koson/psu-hw/Consolidated/KiCad/AC_soft-start,_+5V_power.kicad_sch

## KiCad design Consolidated/KiCad/AC_soft-start,_+5V_power.kicad_sch (2021-06-04)

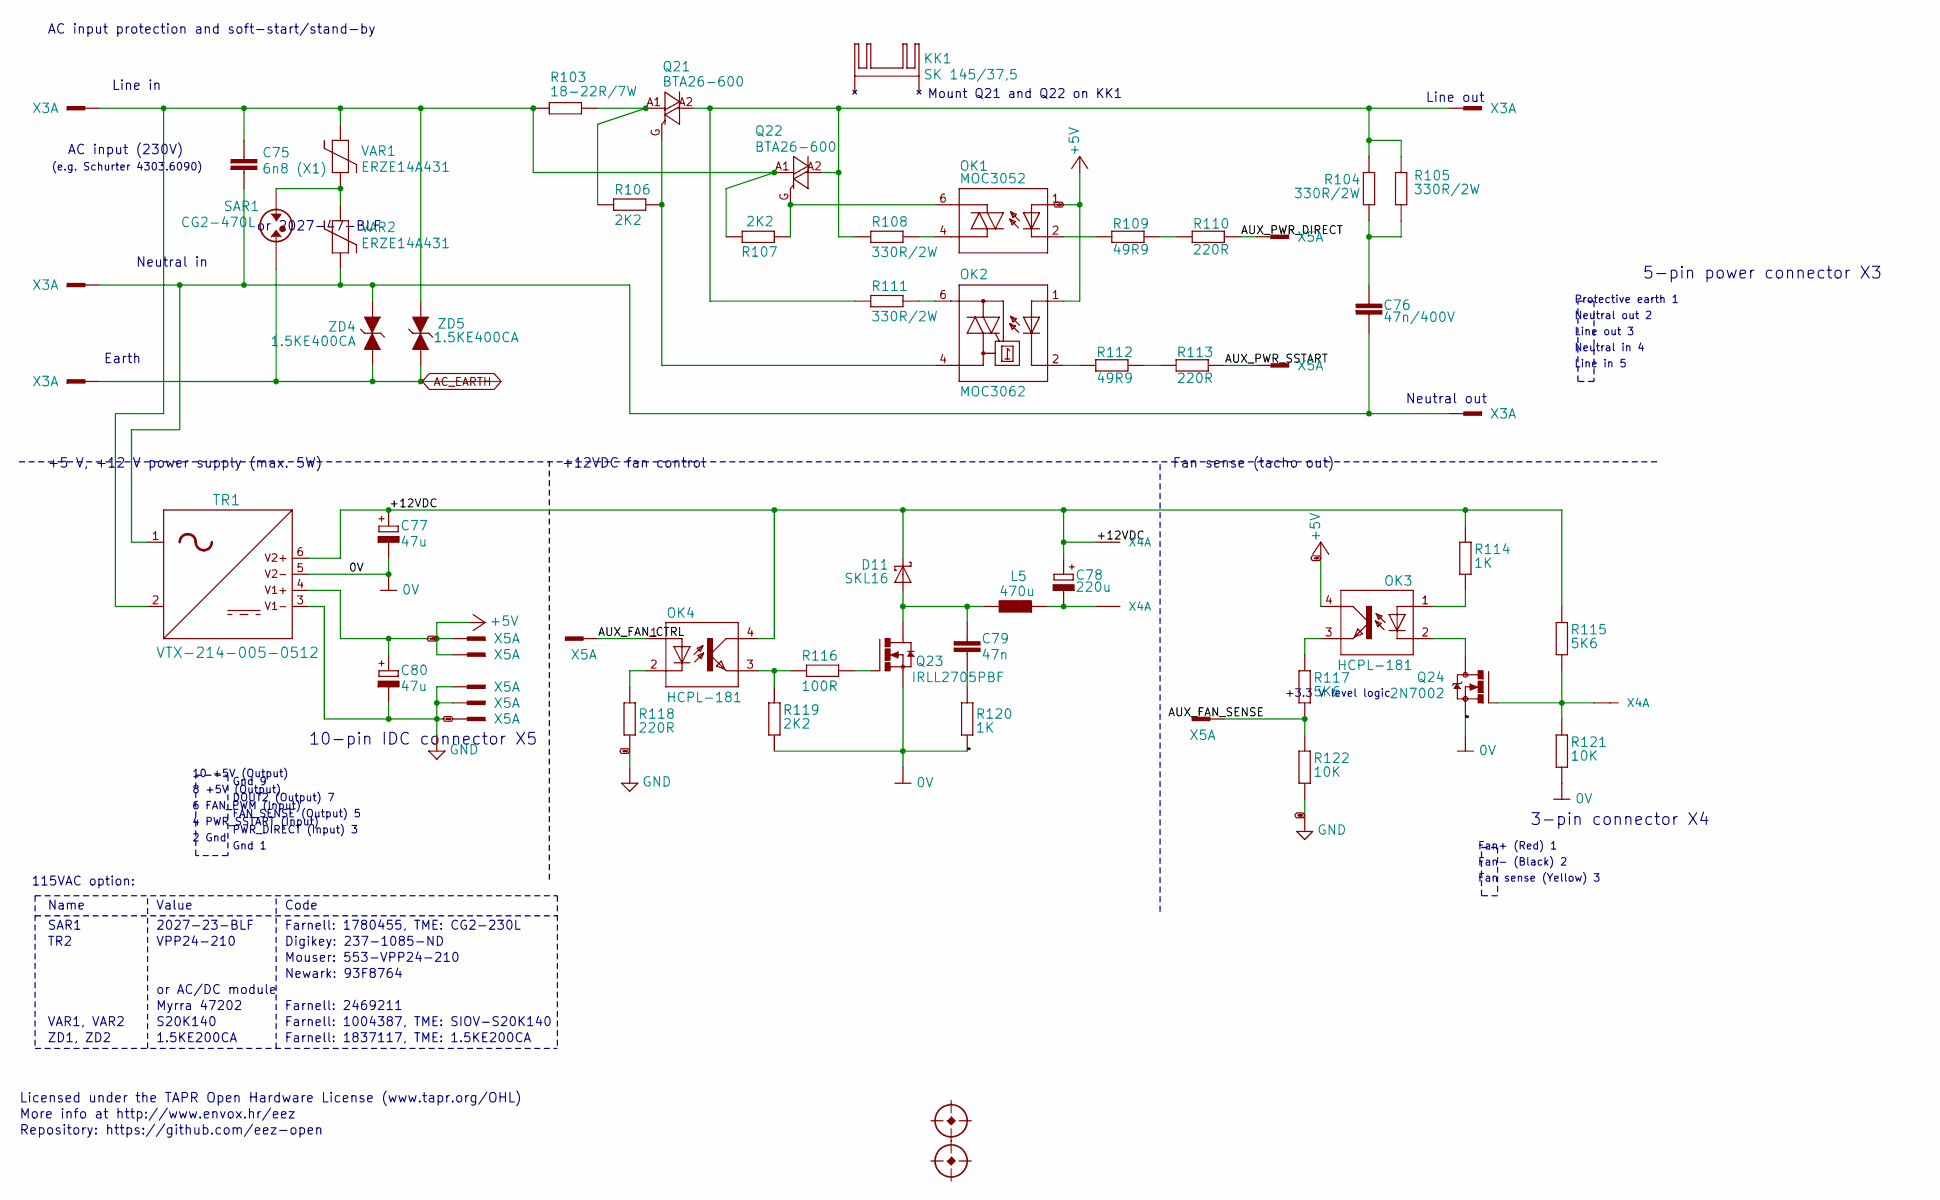
[picture p1: schematic AC_soft-start,_+5V_power.kicad_sch]

Parts:
C75: 6n8 (X1); C102-064X133
C76: 47n/400V; C075-052X106
C77, C80: 47u; CAPAE660X610N
C78: 220u; CAPAE660X610N
C79: 47n; C0805
D11: SKL16; SOD123
FM3, FM4: FIDUCIAL_2; FIDUCIAL_DUAL
KK1: SK 145/37,5; SK145
L5: 470u; DE0704
OK1: MOC3052; DIL6-SMD
OK2: MOC3062; DIL6-SMD
OK3, OK4: HCPL-181
Q21, Q22: BTA26-600; TOP3S-1
Q23: IRLL2705PBF; SOT223
Q24: 2N7002; SOT103P240X110-3N
R103: 18-22R/7W; R_0913
R104, R105, R108, R111: 330R/2W; R2512
R106, R107, R119: 2K2; R0805
R109, R112: 49R9; R0805
R110, R113, R118: 220R; R0805
R114, R120: 1K; R0805
R115, R117: 5K6; R0805
R116: 100R; R0805
R121, R122: 10K; R0805
SAR1: CG2-470L; SAR
TR1: VTX-214-005-0512; PCB_ACDC_VTX_5W_DUAL
VAR1, VAR2: ERZE14A431; VARISTOR
X3: 39303055; MINIFIT_6659-5
X4: 22-23-2031
X5: 09185067324; IDC-10PIN
ZD4, ZD5: 1.5KE400CA; DO201-BIDIR

Connections:
0V: C77.2 (-), Q23.3 (S), Q24.2 (S), R119.1, R120.1, R121.2, TR1.5 (V2-)
+5V: C80.1 (+), OK1.1 (A), OK2.1 (A), OK3.4 (COL), TR1.4 (V1+), X5.1
+12VDC: C77.1 (+), C78.1 (+), D11.C, OK4.4 (COL), R114.1, R115.1, TR1.6 (V2+), X4.1
AC_EARTH: SAR1.P$2, X3.4, ZD4.C (1), ZD5.C (1)
AUX_FAN_CTRL: OK4.1 (A), X5.1
AUX_FAN_SENSE: R117.2, R122.1, X5.1
AUX_PWR_DIRECT: R110.2, X5.1
AUX_PWR_SSTART: R113.2, X5.1
GND: C80.2 (-), R118.2, R122.2, TR1.3 (V1-), X5.1
unnamed: C75.1, Q22.A1, R103.1, R107.2, TR1.2 (IN2), VAR1.P$2, X3.4, ZD5.A (2)
unnamed: C75.2, C76.1, TR1.1 (IN1), VAR2.P$1, X3.4, ZD4.A (2)
unnamed: C76.2, R104.2, R105.2
unnamed: C78.2 (-), L5.1, X4.1
unnamed: C79.1, R120.2
unnamed: C79.2, D11.A, L5.2, Q23.2 (D), Q23.4 (D)
unnamed: OK1.2 (C), R109.1
unnamed: OK1.4 (A1), R108.1
unnamed: OK1.6 (A2), Q22.G, R107.1
unnamed: OK2.2 (C), R112.1
unnamed: OK2.4 (A1), Q21.G, R106.2
unnamed: OK2.6 (A2), R111.1
unnamed: OK3.1 (A), R114.2
unnamed: OK3.2 (C), Q24.3 (D)
unnamed: OK3.3 (EMIT), R117.1
unnamed: OK4.2 (C), R118.1
unnamed: OK4.3 (EMIT), R116.2, R119.2
unnamed: Q21.A1, R103.2, R106.1
unnamed: Q21.A2, Q22.A2, R104.1, R105.1, R108.2, R111.2, X3.4
unnamed: Q23.1 (G), R116.1
unnamed: Q24.1 (G), R115.2, R121.1, X4.1
unnamed: R109.2, R110.1
unnamed: R112.2, R113.1
unnamed: SAR1.P$1, VAR1.P$1, VAR2.P$2

Notes on the sheet:
Licensed under the TAPR Open Hardware License (www.tapr.org/OHL)
More info at http://www.envox.hr/eez
Repository: https://github.com/eez-open
115VAC option:
AC input protection and soft-start/stand-by
+5 V, +12 V power supply (max. 5W)
Name
SAR1
TR2
VAR1, VAR2
ZD1, ZD2
(e.g. Schurter 4303.6090)
AC input (230V)
Earth
Line in
Neutral in
Value
2027-23-BLF
VPP24-210
or AC/DC module
Myrra 47202
S20K140
1.5KE200CA
10 +5V (Output)
8 +5V (Output)
6 FAN_PWM (Input)
4 PWR_SSTART (Input)
2 Gnd
Gnd 9
DOUT2 (Output) 7
FAN_SENSE (Output) 5
PWR_DIRECT (Input) 3
Gnd 1
or 2027-47-BLF
Code
Farnell: 1780455, TME: CG2-230L
Digikey: 237-1085-ND
Mouser: 553-VPP24-210
Newark: 93F8764
Farnell: 2469211
Farnell: 1004387, TME: SIOV-S20K140
Farnell: 1837117, TME: 1.5KE200CA
10-pin IDC connector X5
+12VDC fan control
Mount Q21 and Q22 on KK1
Fan sense (tacho out)
+3.3 V level logic
Neutral out
Line out
Fan+ (Red) 1
Fan- (Black) 2
Fan sense (Yellow) 3
3-pin connector X4
Protective earth 1
Neutral out 2
Line out 3
Neutral in 4
Line in 5
5-pin power connector X3
