koson/psu-hw/Consolidated/KiCad/Bias_power.kicad_sch

## KiCad design Consolidated/KiCad/Bias_power.kicad_sch (2021-06-04)

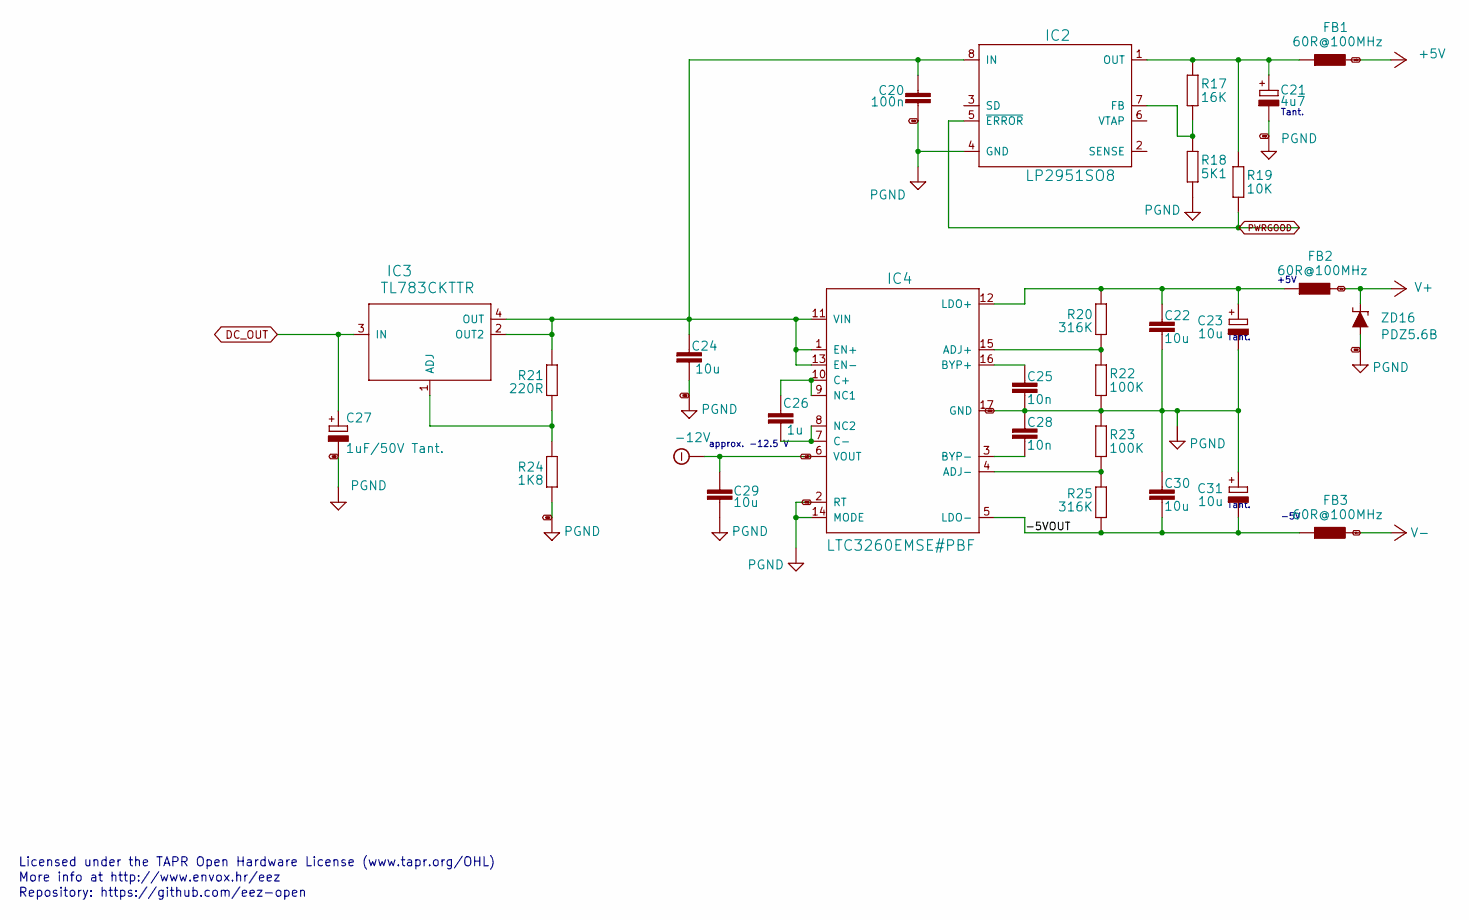
[picture p2: schematic Bias_power.kicad_sch]

Parts:
C20: 100n; C0603
C21: 4u7; EC1206
C22, C24, C29, C30: 10u; C1210
C23, C31: 10u; EC1206
C25, C28: 10n; C0805
C26: 1u; C0805
C27: 1uF/50V Tant.; C_6032-28R
FB1, FB2, FB3: 60R@100MHz; BEAD0603
IC2: LP2951SO8; SOIC127P600X175-8N
IC3: TL783CKTTR; TO254P1524X483-4N
IC4: LTC3260EMSE#PBF; SOP50P490X110-17N
R17: 16K; R0805
R18: 5K1; R0805
R19: 10K; R0805
R20, R25: 316K; R0805
R21: 220R; R0805
R22, R23: 100K; R0805
R24: 1K8; R0805
ZD16: PDZ5.6B; SOD323-W

Connections:
+5V: FB1.P$2 (2)
-5VOUT: C30.2, C31.-, FB3.P$1 (1), IC4.5 (LDO-), R25.2
-12V: C29.1, IC4.6 (VOUT)
DC_OUT: C27.+, IC3.3 (IN)
GND: C20.2, C21.-, C22.2, C23.-, C24.2, C25.1, C27.-, C28.1, C29.2, C30.1, C31.+, IC2.4 (GND), IC4.2 (RT), IC4.14 (MODE), IC4.17 (GND), R18.2, R22.2, R23.1, R24.2, ZD16.A
unnamed: C20.1, C24.1, IC2.8 (IN), IC3.2 (OUT2), IC3.4 (OUT), IC4.1 (EN+), IC4.11 (VIN), IC4.13 (EN-), R21.1
unnamed: C21.+, FB1.P$1 (1), IC2.1 (OUT), R17.1, R19.1
unnamed: C22.1, C23.+, FB2.P$1 (1), IC4.12 (LDO+), R20.1
unnamed: C25.2, IC4.16 (BYP+)
unnamed: C26.1, IC4.9 (NC1), IC4.10 (C+)
unnamed: C26.2, IC4.7 (C-), IC4.8 (NC2)
unnamed: C28.2, IC4.3 (BYP-)
unnamed: IC2.7 (FB), R17.2, R18.1
unnamed: IC3.1 (ADJ), R21.2, R24.1
unnamed: IC4.4 (ADJ-), R23.2, R25.1
unnamed: IC4.15 (ADJ+), R20.2, R22.1
PWRGOOD: IC2.5 (~ERROR), R19.2
V+: FB2.P$2 (2), ZD16.C
V-: FB3.P$2 (2)

Notes on the sheet:
Licensed under the TAPR Open Hardware License (www.tapr.org/OHL)
More info at http://www.envox.hr/eez
Repository: https://github.com/eez-open
approx. -12.5 V
Tant.
+5V
-5V
