koson/psu-hw/Consolidated/KiCad/Binding_posts_relays,_LED_driver.kicad_sch

## KiCad design Consolidated/KiCad/Binding_posts_relays,_LED_driver.kicad_sch (2021-06-04)

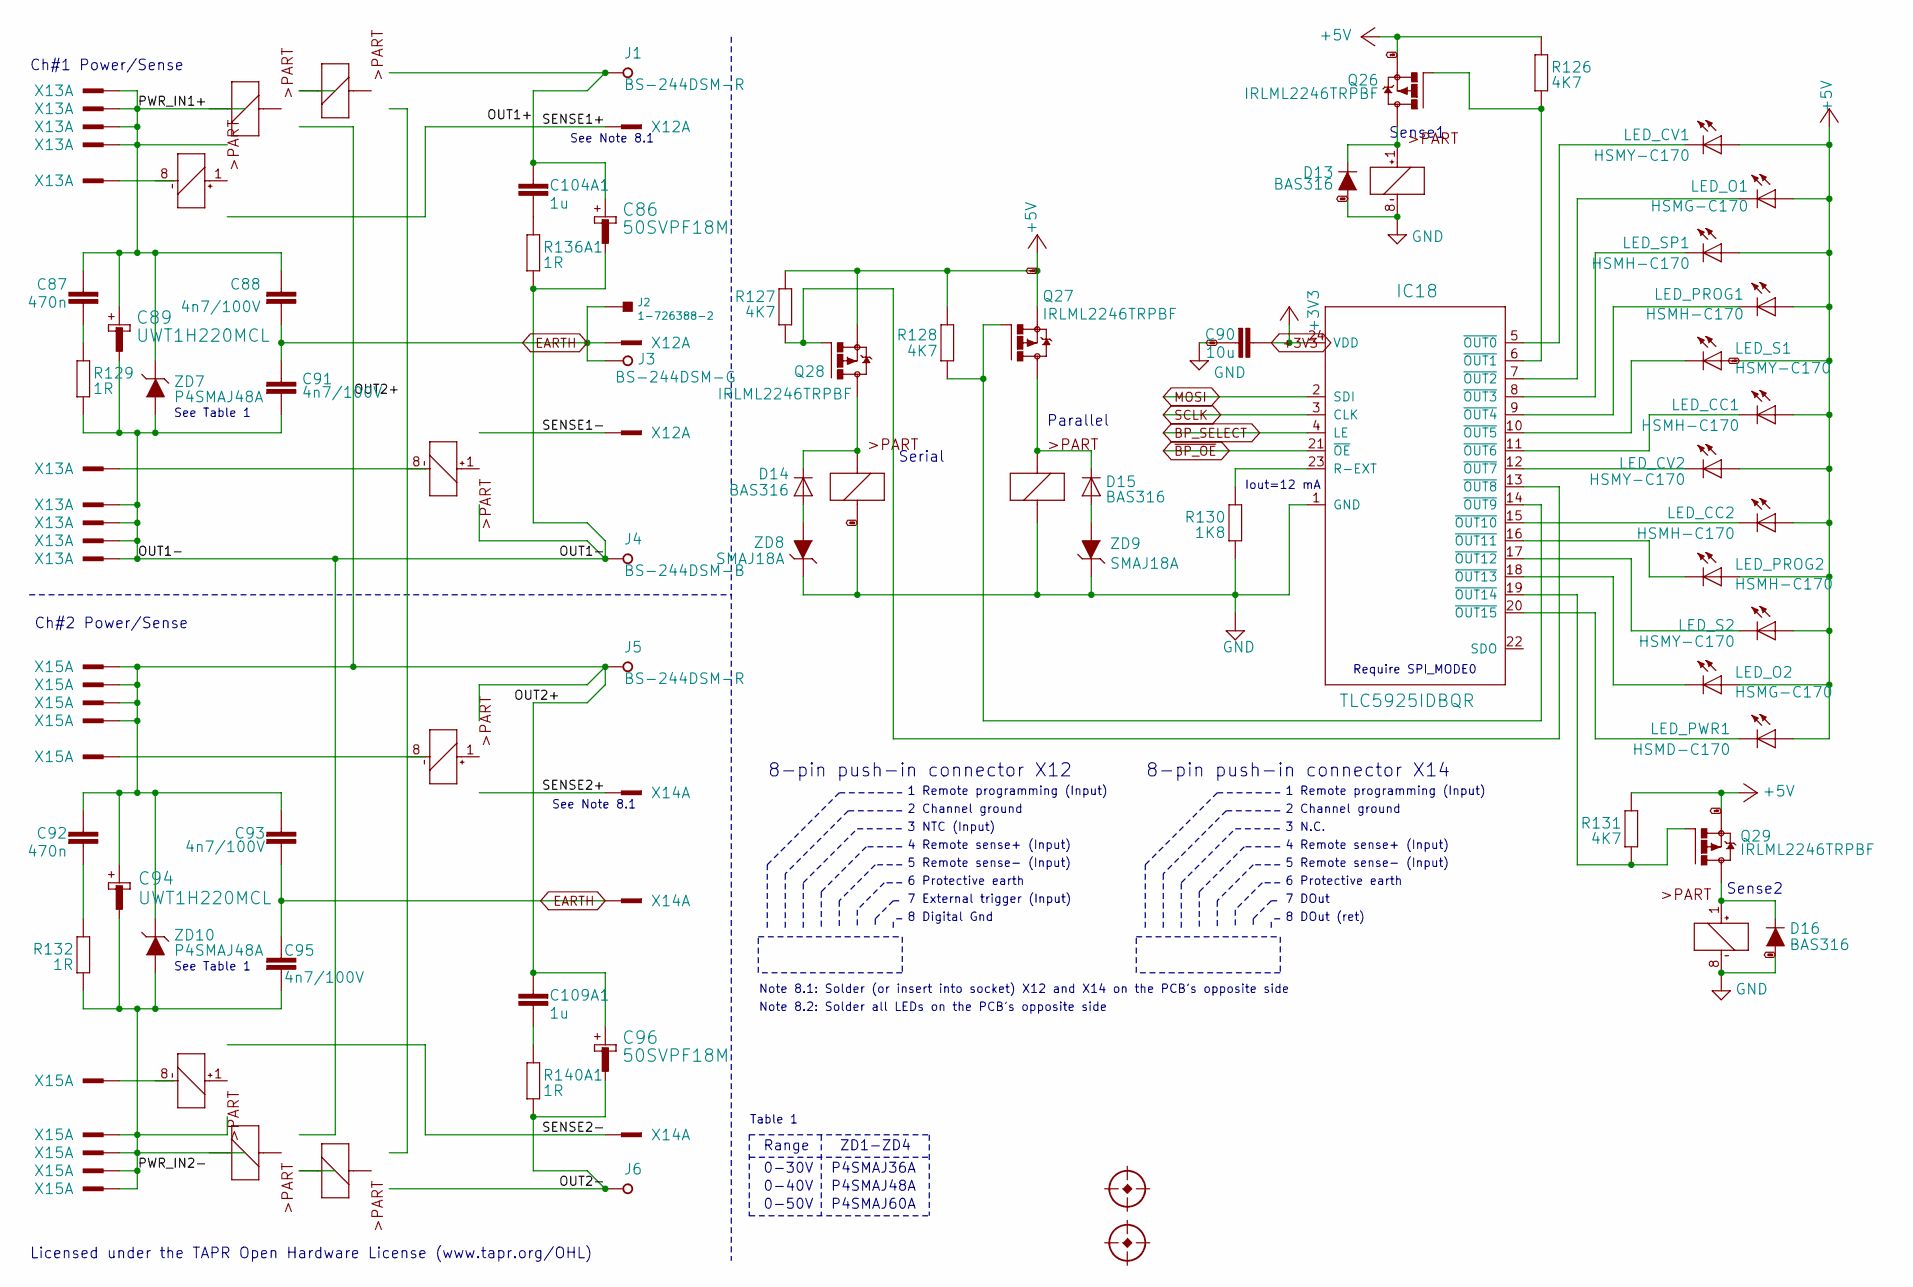
[picture p3: schematic Binding_posts_relays,_LED_driver.kicad_sch]

Parts:
C86, C96: 50SVPF18M; CAPAE830X650N
C87, C92: 470n; C0805
C88, C91, C93, C95: 4n7/100V; C1210
C89, C94: UWT1H220MCL; CAPAE830X650N
C90: 10u; C1210
C104A1, C109A1: 1u; C0805
D13, D16: BAS316; SOD323-R
D14, D15: BAS316; SOD323-W
FM5, FM6: FIDUCIAL_2; FIDUCIAL_DUAL
IC18: TLC5925IDBQR; SOP63P600X175-24N
J1, J5: BS-244DSM-R; BP_5_12
J2: 1-726388-2; PCB_TAB-4.8MM
J3: BS-244DSM-G; BP_5_12
J4, J6: BS-244DSM-B; BP_5_12
K_PAR1: RT424005; RT-C_016A5_ROUND
K_S1, K_S2: G6K-2F-5DC; G6K-2F
K_SER1: RT424005; RT-C_016A5_ROUND
LED_CC1, LED_CC2: HSMH-C170; LED_HSMH-C170
LED_CV1, LED_CV2: HSMY-C170; LED_0805
LED_O1, LED_O2: HSMG-C170; LED_0805
LED_PROG1, LED_PROG2: HSMH-C170; LED_HSMH-C170
LED_PWR1: HSMD-C170; LED_0805
LED_S1, LED_S2: HSMY-C170; LED_0805
LED_SP1: HSMH-C170; LED_HSMH-C170
Q26, Q27, Q28, Q29: IRLML2246TRPBF; SOT95P237X112-3N
R126, R127, R128, R131: 4K7; R0805
R129, R132, R136A1, R140A1: 1R; R0805
R130: 1K8; R0805
X12, X14: MC000006; MC000006_MIRROR
X13, X15: TSW-113-07-F-D
ZD7, ZD10: P4SMAJ48A; DO214AC
ZD8, ZD9: SMAJ18A; DO214AC

Connections:
+3V3: C90.1, IC18.24 (VDD)
+5V: LED_CC1.A, LED_CC2.A, LED_CV1.A, LED_CV2.A, LED_O1.A, LED_O2.A, LED_PROG1.A, LED_PROG2.A, LED_PWR1.A, LED_S1.A, LED_S2.A, LED_SP1.A, Q26.2 (S), Q27.2 (S), Q28.2 (S), Q29.2 (S), R126.2, R127.2, R128.2, R131.2
BP_SELECT: IC18.4 (LE)
EARTH: C88.2, C91.1, C93.2, C95.1, J2.P$1, J2.P$2, J3.P$1, X12.1, X12.1.1, X14.1, X14.1.1
GND: C90.2, D13.A, D16.A, IC18.1 (GND), K_PAR1.A1 (C2), K_S1.8 (-), K_S2.8 (-), K_SER1.A1 (C2), R130.1, ZD8.C, ZD9.C
MOSI: IC18.2 (SDI)
unnamed: C87.2, R129.2
unnamed: C92.2, R132.2
unnamed: C104A1.2, R136A1.2
unnamed: C109A1.2, R140A1.2
unnamed: D13.C, K_S1.1 (+), Q26.3 (D)
unnamed: D14.A, ZD8.A
unnamed: D14.C, K_SER1.A2 (C1), Q28.3 (D)
unnamed: D15.A, ZD9.A
unnamed: D15.C, K_PAR1.A2 (C1), Q27.3 (D)
unnamed: D16.C, K_S2.1 (+), Q29.3 (D)
unnamed: IC18.5 (~OUT0), LED_CV1.C
unnamed: IC18.6 (~OUT1), Q26.1 (G), R126.1
unnamed: IC18.7 (~OUT2), LED_O1.C
unnamed: IC18.8 (~OUT3), LED_SP1.C
unnamed: IC18.9 (~OUT4), LED_PROG1.C
unnamed: IC18.10 (~OUT5), LED_S1.C
unnamed: IC18.11 (~OUT6), LED_CC1.C
unnamed: IC18.12 (~OUT7), LED_CV2.C
unnamed: IC18.13 (~OUT8), Q28.1 (G), R127.1
unnamed: IC18.14 (~OUT9), Q27.1 (G), R128.1
unnamed: IC18.15 (~OUT10), LED_CC2.C
unnamed: IC18.16 (~OUT11), LED_PROG2.C
unnamed: IC18.17 (~OUT12), LED_S2.C
unnamed: IC18.18 (~OUT13), LED_O2.C
unnamed: IC18.19 (~OUT14), Q29.1 (G), R131.1
unnamed: IC18.20 (~OUT15), LED_PWR1.C
unnamed: IC18.23 (R-EXT), R130.2
OUT1+: C86.1, C104A1.1, J1.P$1
OUT1-: C86.2, C89.2, C91.2, J4.P$1, R129.1, R136A1.1, X13.1, ZD7.A
OUT2+: C92.1, C93.1, C94.1, C96.1, C109A1.1, J5.P$1, X15.1, ZD10.C
OUT2-: C96.2, J6.P$1, R140A1.1
PWR_IN1+: C87.1, C88.1, C89.1, X13.1, ZD7.C
PWR_IN2-: C94.2, C95.2, R132.1, X15.1, ZD10.A
SCLK: IC18.3 (CLK)
SENSE1+: X12.1, X12.1.1
SENSE1-: X12.1, X12.1.1
SENSE2+: X14.1, X14.1.1
SENSE2-: X14.1, X14.1.1
~BP_OE: IC18.21 (~OE)

Notes on the sheet:
Ch#1 Power/Sense
Licensed under the TAPR Open Hardware License (www.tapr.org/OHL)
Ch#2 Power/Sense
See Table 1
See Note 8.1
Table 1
Note 8.1: Solder (or insert into socket~) X12 and X14 on the PCB's opposite side
Note 8.2: Solder all LEDs on the PCB's opposite side
Range
0-30V
0-40V
0-50V
8-pin push-in connector X12
P4SMAJ36A
P4SMAJ48A
P4SMAJ60A
ZD1-ZD4
Serial
1 Remote programming (Input)
2 Channel ground
3 NTC (Input)
4 Remote sense+ (Input)
5 Remote sense- (Input)
6 Protective earth
7 External trigger (Input)
8 Digital Gnd
Parallel
8-pin push-in connector X14
Iout=12 mA
3 N.C.
7 DOut
8 DOut (ret)
Require SPI_MODE0
Sense1
Sense2
