koson/psu-hw/Consolidated/KiCad/CC%2fCV,_Remote_sense_protection.kicad_sch

## KiCad design Consolidated/KiCad/CC%2fCV,_Remote_sense_protection.kicad_sch (2021-06-04)

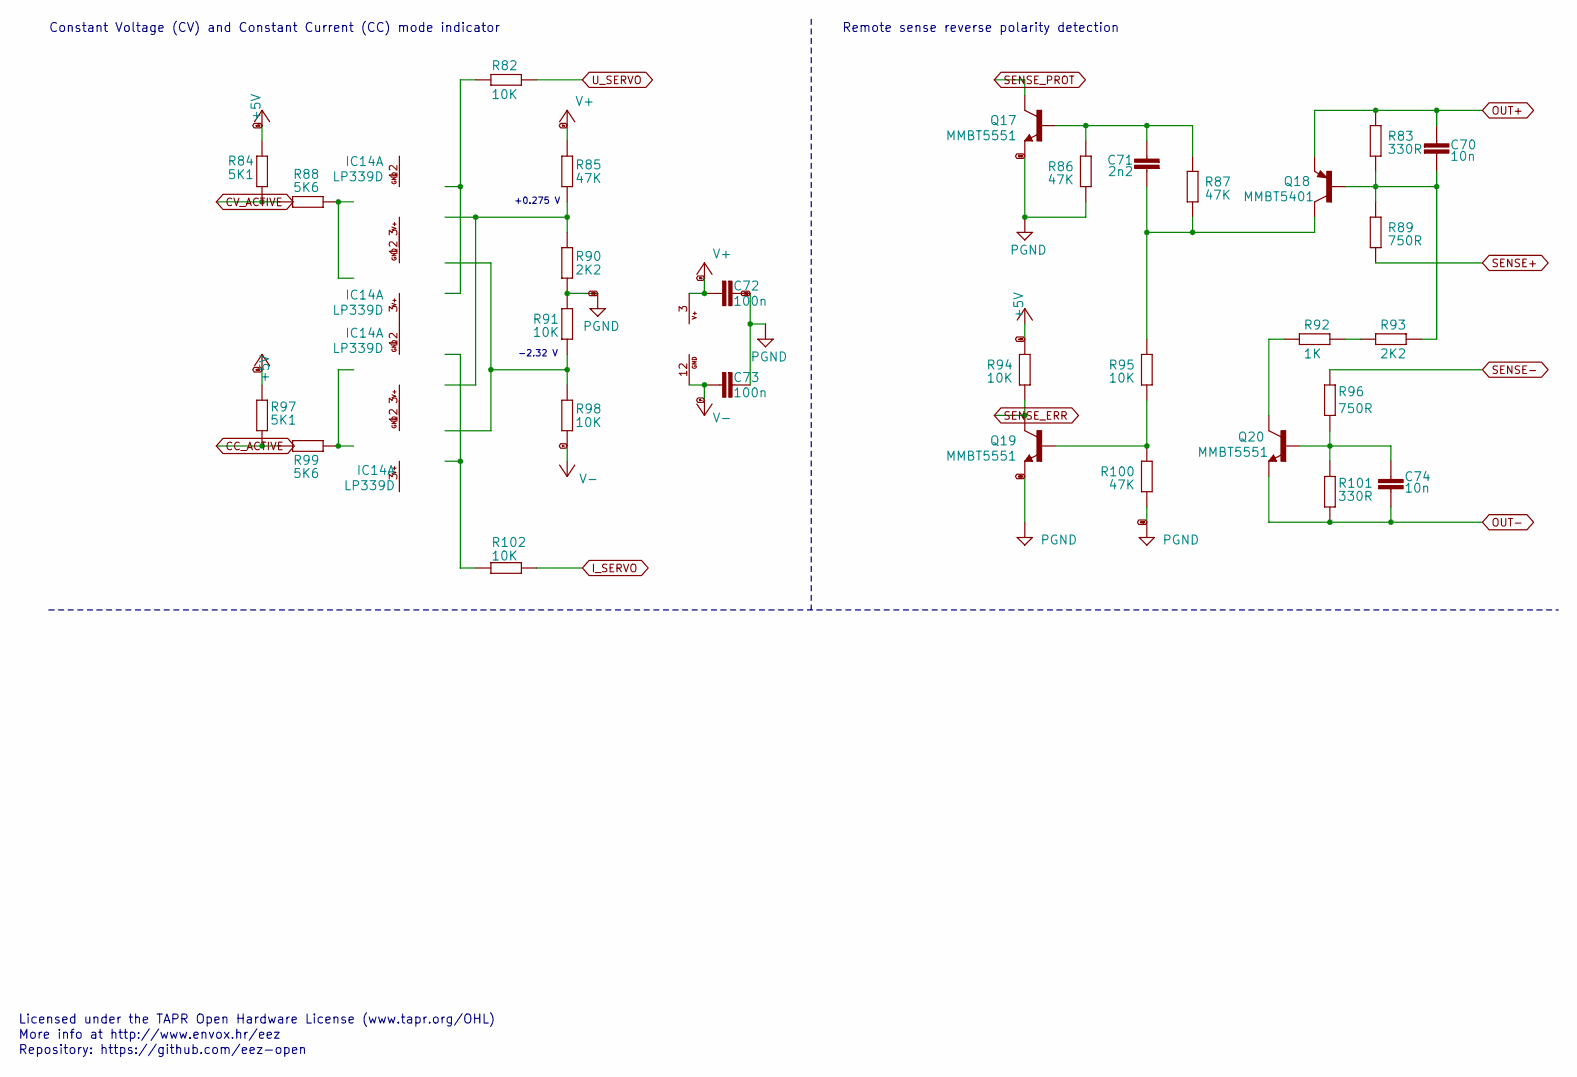
[picture p4: schematic CC%2fCV,_Remote_sense_protection.kicad_sch]

Parts:
C70, C74: 10n; C0805
C71: 2n2; C0805
C72, C73: 100n; C0603
IC14: LP339D; SOIC127P600X175-14N
Q17, Q19, Q20: MMBT5551; SOT23-BEC
Q18: MMBT5401; SOT23-BEC
R82, R91, R94, R95, R98, R102: 10K; R0805
R83, R101: 330R; R0805
R84, R97: 5K1; R0805
R85, R86, R87, R100: 47K; R0805
R88, R99: 5K6; R0805
R89, R96: 750R; R0805
R90, R93: 2K2; R0805
R92: 1K; R0805

Connections:
+5V: R84.2, R94.2, R97.2
CC_ACTIVE: R97.1, R99.2
CV_ACTIVE: R84.1, R88.2
GND: C72.1, C73.1, Q17.E, Q19.E, R86.1, R90.1, R91.2, R100.1
I_SERVO: R102.1
unnamed: C70.2, Q18.B, R83.1, R89.2, R93.2
unnamed: C71.1, Q17.B, R86.2, R87.2
unnamed: C71.2, Q18.C, R87.1, R95.2
unnamed: C74.1, Q20.B, R96.1, R101.2
unnamed: IC14.3 (V+), IC14.12 (GND)
unnamed: Q19.B, R95.1, R100.2
unnamed: Q20.C, R92.1
unnamed: R85.1, R90.2
unnamed: R91.1, R98.2
unnamed: R92.2, R93.1
OUT+: C70.1, Q18.E, R83.2
OUT-: C74.2, Q20.E, R101.1
SENSE+: R89.1
SENSE-: R96.2
SENSE_ERR: Q19.C, R94.1
SENSE_PROT: Q17.C
U_SERVO: R82.1
V+: C72.2, IC14.3 (V+), R85.2
V-: C73.2, IC14.12 (GND), R98.1

Notes on the sheet:
Licensed under the TAPR Open Hardware License (www.tapr.org/OHL)
More info at http://www.envox.hr/eez
Repository: https://github.com/eez-open
Constant Voltage (CV) and Constant Current (CC) mode indicator
+0.275 V
-2.32 V
Remote sense reverse polarity detection
