koson/psu-hw/Consolidated/KiCad/Digital_control,_voltage_reference.kicad_sch

## KiCad design Consolidated/KiCad/Digital_control,_voltage_reference.kicad_sch (2021-06-04)

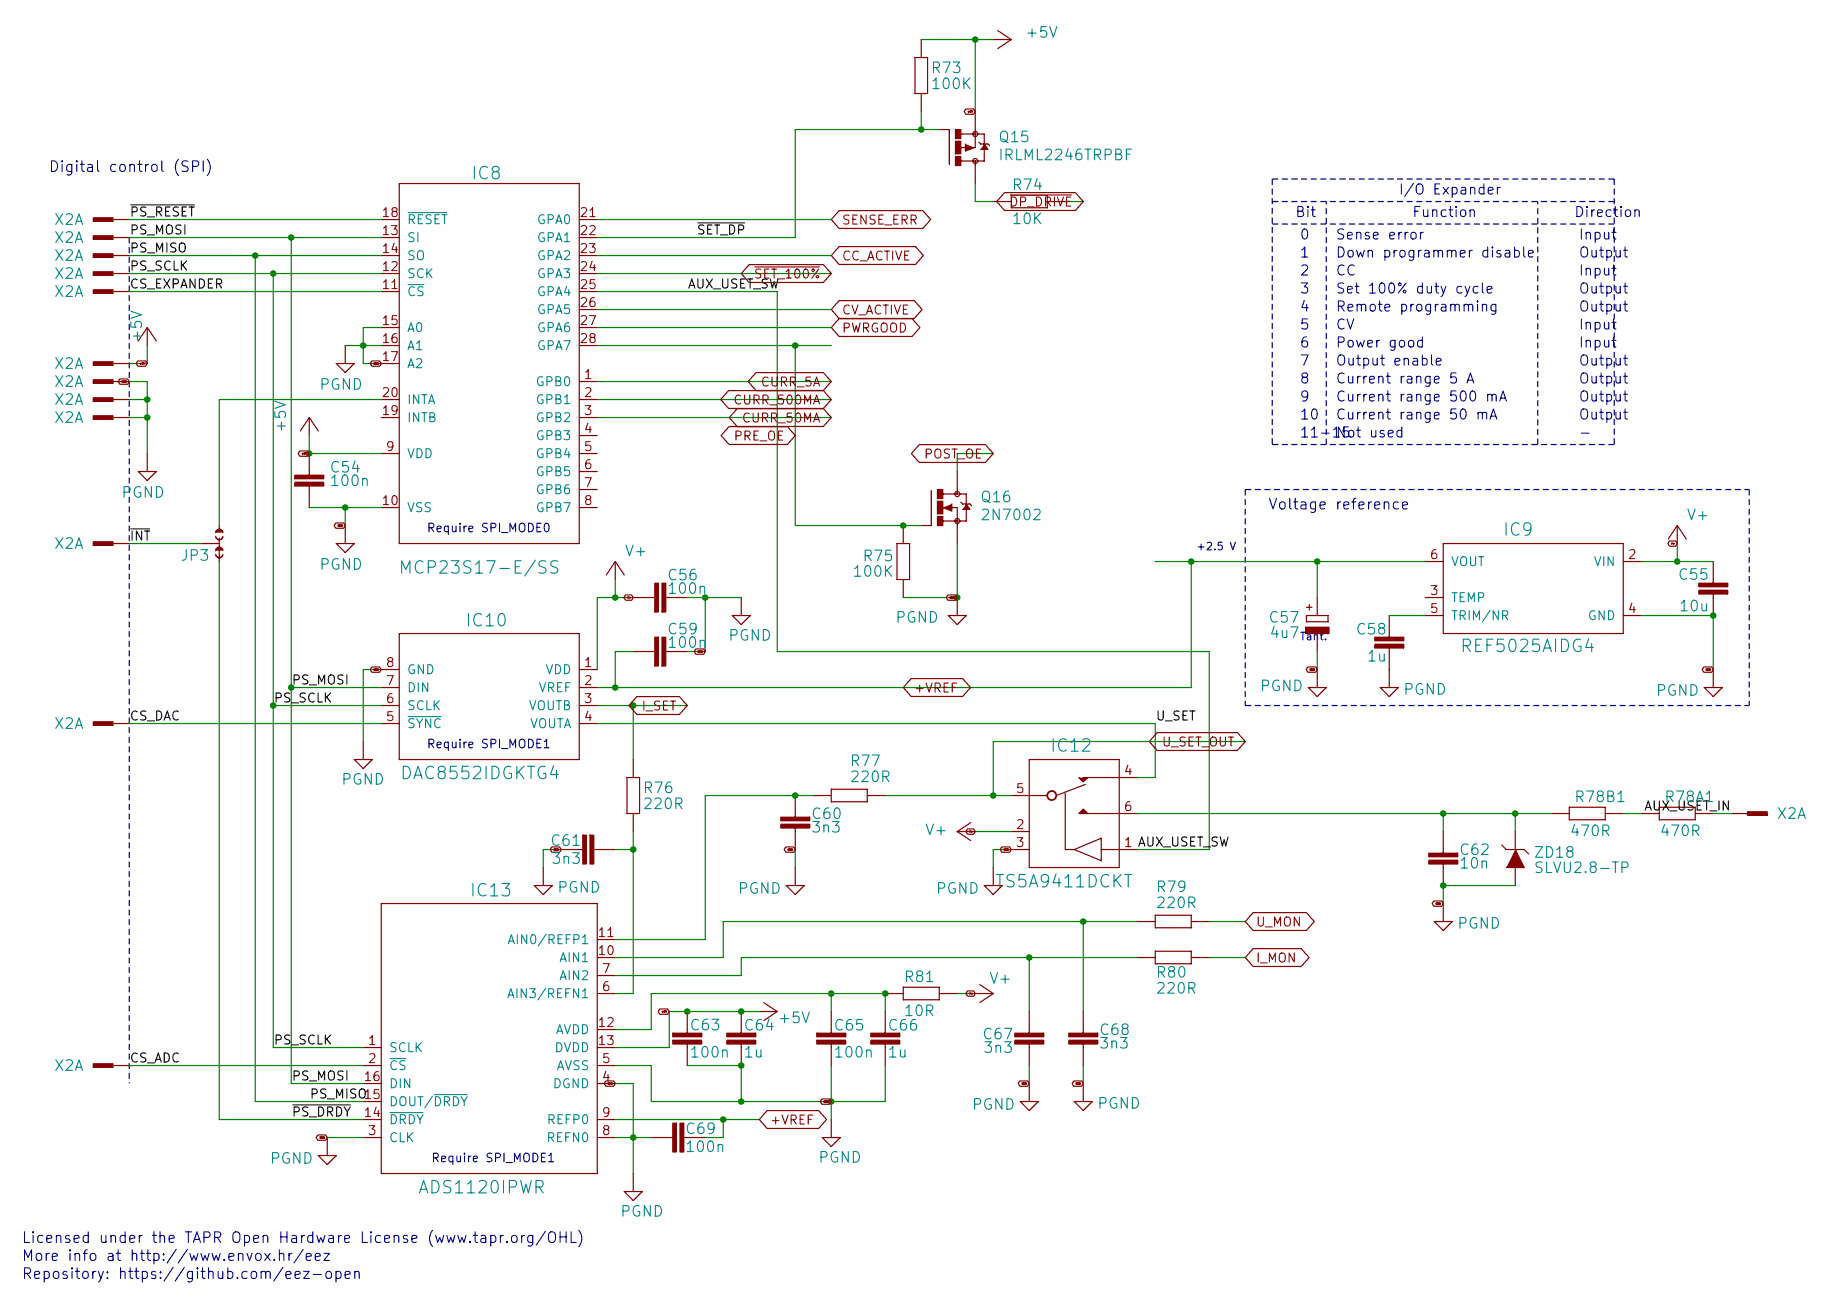
[picture p5: schematic Digital_control,_voltage_reference.kicad_sch]

Parts:
C54, C56, C59, C63, C65, C69: 100n; C0603
C55: 10u; C1210
C57: 4u7; EC1206
C58, C64, C66: 1u; C0805
C60, C61, C67, C68: 3n3; C0805
C62: 10n; C0805
IC8: MCP23S17-E/SS; SOP65P780X200-28N
IC9: REF5025AIDG4; SOIC127P600X175-8N
IC10: DAC8552IDGKTG4; DGK8-M
IC12: TS5A9411DCKT; SOT65P210X110-6N
IC13: ADS1120IPWR; PW(R-PDSO-G16)
JP3: JP3-CUT
Q15: IRLML2246TRPBF; SOT95P237X112-3N
Q16: 2N7002; SOT103P240X110-3N
R73, R75: 100K; R0805
R74: 10K; R0805
R76, R77, R79, R80: 220R; R0805
R78A1, R78B1: 470R; R0805
R81: 10R; R1206
X2: SSW-113-02-T-D-RA
ZD18: SLVU2.8-TP; SOT23

Connections:
+5V: C54.1, C63.2, C64.2, IC8.9 (VDD), IC13.13 (DVDD), Q15.2 (S), R73.1, X2.1
+VREF: C57.+, C59.2, C69.2, IC9.6 (VOUT), IC10.2 (VREF), IC13.9 (REFP0)
AUX_USET_IN: R78A1.2, X2.1
AUX_USET_SW: IC8.25 (GPA4), IC12.1 (IN)
CC_ACTIVE: IC8.23 (GPA2)
CS_ADC: IC13.2 (~CS), X2.1
CS_DAC: IC10.5 (~SYNC), X2.1
CS_EXPANDER: IC8.11 (~CS), X2.1
CURR_5A: IC8.1 (GPB0)
CURR_50MA: IC8.3 (GPB2)
CURR_500MA: IC8.2 (GPB1)
CV_ACTIVE: IC8.26 (GPA5)
GND: C54.2, C55.2, C56.1, C57.-, C58.2, C59.1, C60.1, C61.2, C62.1, C63.1, C64.1, C65.1, C66.1, C67.1, C68.1, C69.1, IC8.10 (VSS), IC8.15 (A0), IC8.16 (A1), IC8.17 (A2), IC9.4 (GND), IC10.8 (GND), IC12.3 (GND), IC13.3 (CLK), IC13.4 (DGND), IC13.5 (AVSS), IC13.8 (REFN0), Q16.2 (S), R75.1, X2.1, ZD18.1 (A), ZD18.2 (A)
I_MON: R80.1
I_SET: IC10.3 (VOUTB), R76.1
unnamed: C58.1, IC9.5 (TRIM/NR)
unnamed: C60.2, IC13.11 (AIN0/REFP1), R77.2
unnamed: C61.1, IC13.6 (AIN3/REFN1), R76.2
unnamed: C62.2, IC12.6 (S1), R78B1.1, ZD18.3 (C)
unnamed: C65.2, C66.2, IC13.12 (AVDD), R81.2
unnamed: C67.2, IC13.7 (AIN2), R80.2
unnamed: C68.2, IC13.10 (AIN1), R79.2
unnamed: IC8.20 (INTA), JP3.NO
unnamed: Q15.3 (D), R74.2
unnamed: R78A1.1, R78B1.2
POST_OE: Q16.3 (D)
PRE_OE: IC8.28 (GPA7), Q16.1 (G), R75.2
PS_MISO: IC8.14 (SO), IC13.15 (DOUT/~DRDY), X2.1
PS_MOSI: IC8.13 (SI), IC10.7 (DIN), IC13.16 (DIN), X2.1
PS_SCLK: IC8.12 (SCK), IC10.6 (SCLK), IC13.1 (SCLK), X2.1
PWRGOOD: IC8.27 (GPA6)
SENSE_ERR: IC8.21 (GPA0)
U_MON: R79.1
U_SET: IC10.4 (VOUTA), IC12.4 (S2)
U_SET_OUT: IC12.5 (D), R77.1
V+: C55.1, C56.2, IC9.2 (VIN), IC10.1 (VDD), IC12.2 (VDD), R81.1
~DP_DRIVE: R74.1
~INT: JP3.COM, X2.1
~PS_DRDY: IC13.14 (~DRDY), JP3.NC
~PS_RESET: IC8.18 (~RESET), X2.1
~SET_100%: IC8.24 (GPA3)
~SET_DP: IC8.22 (GPA1), Q15.1 (G), R73.2

Notes on the sheet:
Licensed under the TAPR Open Hardware License (www.tapr.org/OHL)
More info at http://www.envox.hr/eez
Repository: https://github.com/eez-open
Digital control (SPI)
Require SPI_MODE0
Require SPI_MODE1
+2.5 V
Voltage reference
Bit
11-15
Tant.
Sense error
Down programmer disable
Set 100% duty cycle
Remote programming
Power good
Output enable
Current range 5 A
Current range 500 mA
Current range 50 mA
Not used
I/O Expander
Function
Direction
Input
Output
