koson/psu-hw/Consolidated/KiCad/EEZ_PSU_consolidated_r5B13a_12.kicad_sch

## KiCad design Consolidated/KiCad/EEZ_PSU_consolidated_r5B13a_12.kicad_sch (2021-06-04)

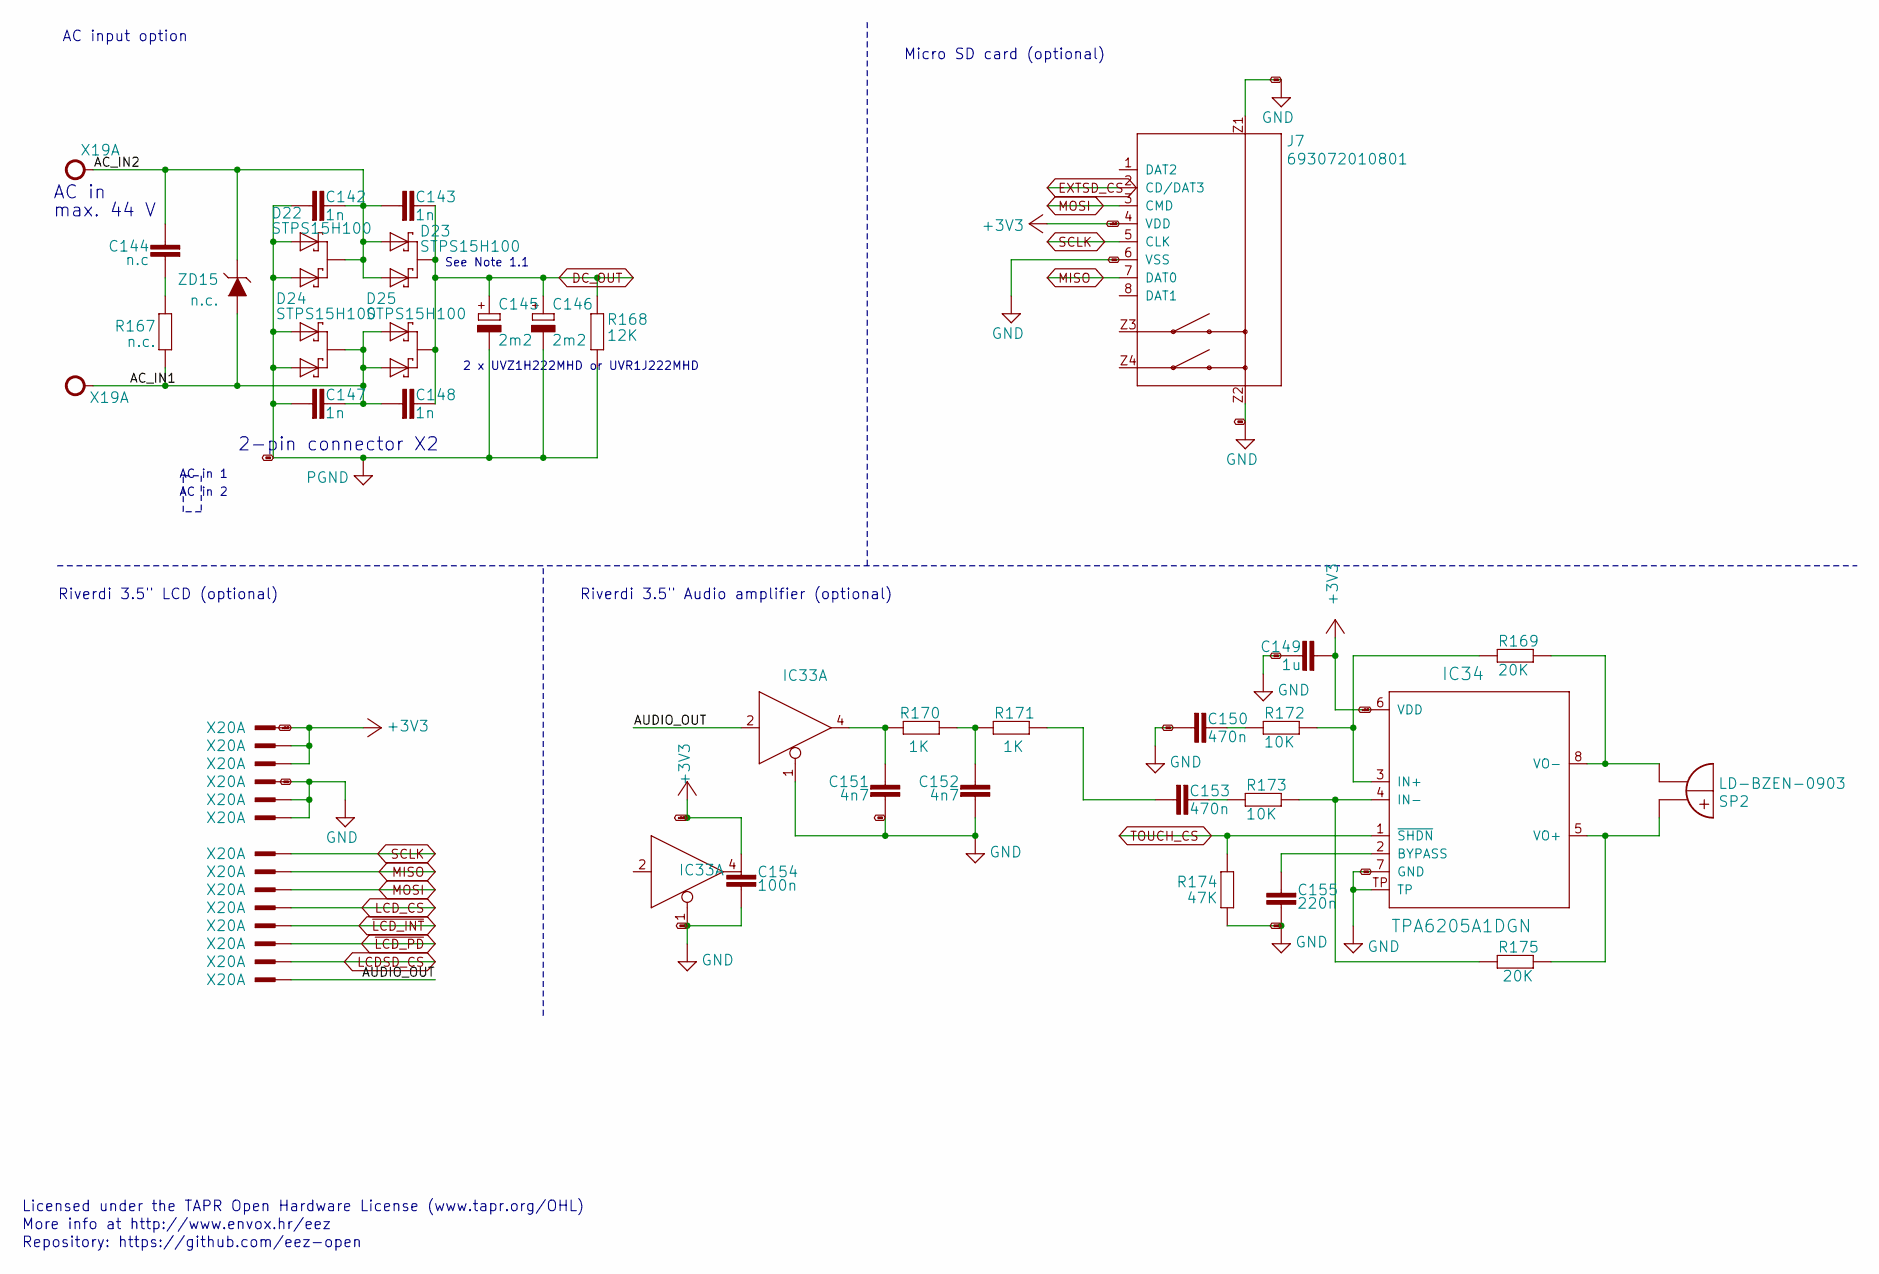
[picture p6: schematic EEZ_PSU_consolidated_r5B13a_12.kicad_sch]

Parts:
C142, C143, C147, C148: 1n; C1206
C144: n.c; C1206
C145, C146: 2m2; ECAP7.5_18
C149: 1u; C0805
C150, C153: 470n; C0805
C151, C152: 4n7; C0805
C154: 100n; C0603
C155: 220n; C0805
D22, D23, D24, D25: STPS15H100; TO252
IC33: 74LVC1G125GW.125; SOT65P210X110-5N
IC34: TPA6205A1DGN; SOP65P490X110-9N
J7: 693072010801
R167: n.c.; R1206
R168: 12K; R1206
R169, R175: 20K; R0805
R170, R171: 1K; R0805
R172, R173: 10K; R0805
R174: 47K; R0805
SP2: LD-BZEN-0903
X19: 282836-2; TBLOCK5.0_2
X20: PCA-6B-20-HL-3 or 52746-2071; FPC-20_ROTATED
ZD15: n.c.; DO214AA

Connections:
+3V3: C149.2, C154.2, IC34.6 (VDD), J7.4 (VDD), X20.1
AC_IN1: C147.1, C148.2, D24.3 (C), D25.1 (A1), D25.2 (A2), R167.2, X19.1, ZD15.A
AC_IN2: C142.1, C143.2, C144.1, D22.3 (C), D23.1 (A1), D23.2 (A2), X19.1, ZD15.C
AUDIO_OUT: IC33.2 (I), X20.1
DC_OUT: C143.1, C145.+, C146.+, C148.1, D23.3 (C), D25.3 (C), R168.1
EXTSD_CS: J7.2 (CD/DAT3)
GND: C142.2, C145.-, C146.-, C147.2, C149.1, C150.2, C151.2, C152.2, C154.1, C155.1, D22.1 (A1), D22.2 (A2), D24.1 (A1), D24.2 (A2), IC33.1 (OE), IC34.7 (GND), IC34.TP, J7.6 (VSS), J7.Z1, J7.Z2, R168.2, R174.2, X20.1
LCDSD_CS: X20.1
LCD_CS: X20.1
MISO: J7.7 (DAT0), X20.1
MOSI: J7.3 (CMD), X20.1
unnamed: C144.2, R167.1
unnamed: C150.1, R172.2
unnamed: C151.1, IC33.4 (O), R170.2
unnamed: C152.1, R170.1, R171.2
unnamed: C153.1, R173.2
unnamed: C153.2, R171.1
unnamed: C155.2, IC34.2 (BYPASS)
unnamed: IC34.3 (IN+), R169.2, R172.1
unnamed: IC34.4 (IN-), R173.1, R175.2
unnamed: IC34.5 (VO+), R175.1, SP2.+B (+)
unnamed: IC34.8 (VO-), R169.1, SP2.-B (-)
SCLK: J7.5 (CLK), X20.1
TOUCH_CS: IC34.1 (~SHDN), R174.1
~LCD_INT: X20.1
~LCD_PD: X20.1

Notes on the sheet:
Licensed under the TAPR Open Hardware License (www.tapr.org/OHL)
More info at http://www.envox.hr/eez
Repository: https://github.com/eez-open
AC in
max. 44 V
Riverdi 3.5" LCD (optional)
AC input option
AC in 1
AC in 2
2-pin connector X2
See Note 1.1
2 x UVZ1H222MHD or UVR1J222MHD
Riverdi 3.5" Audio amplifier (optional)
Micro SD card (optional)
