koson/psu-hw/Consolidated/KiCad/Ethernet,_USB,_Fan.kicad_sch

## KiCad design Consolidated/KiCad/Ethernet,_USB,_Fan.kicad_sch (2021-06-04)

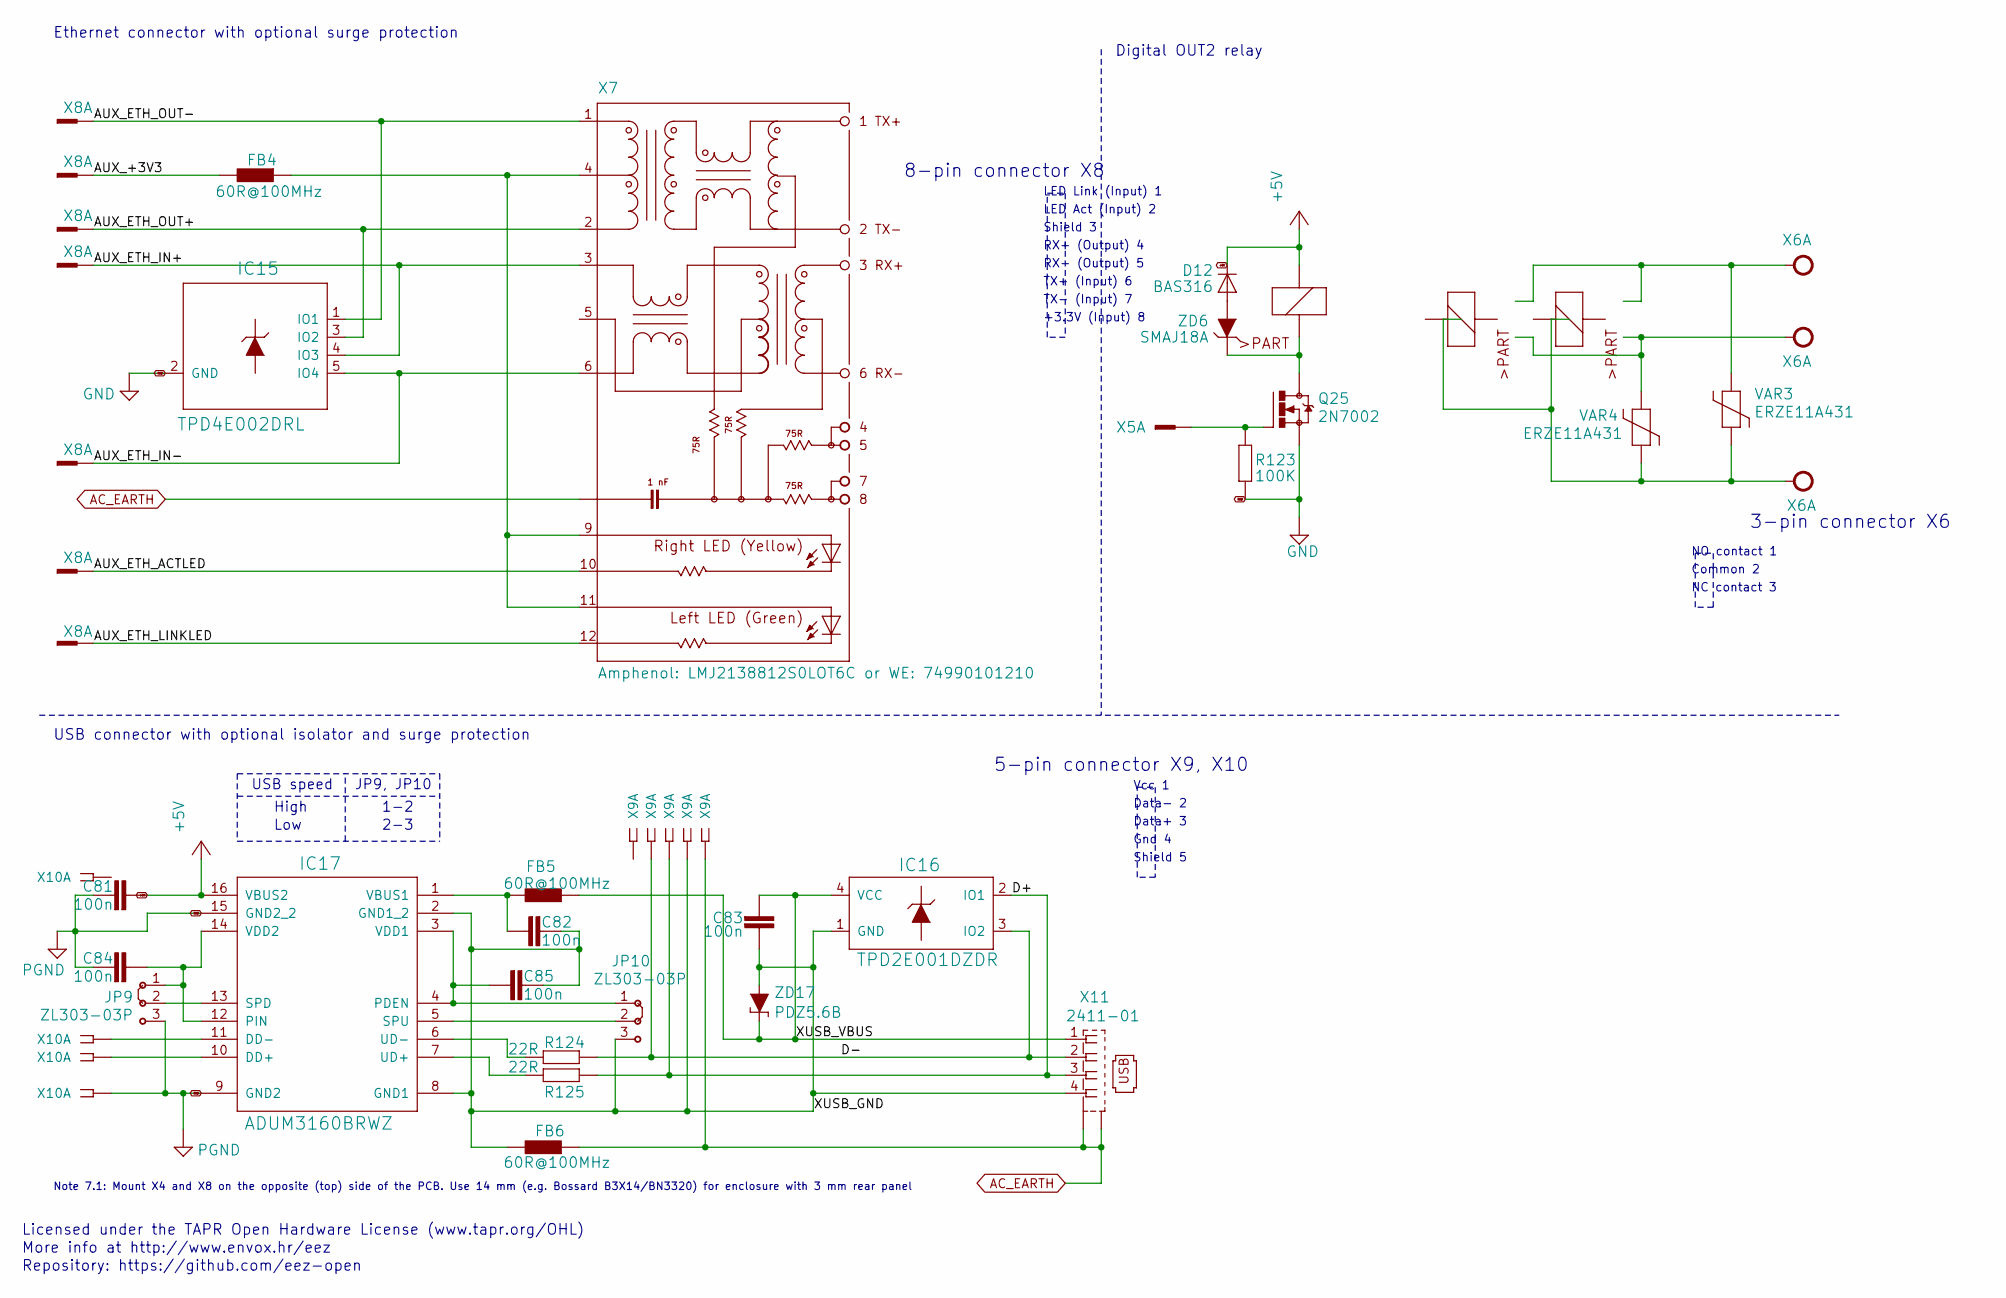
[picture p7: schematic Ethernet,_USB,_Fan.kicad_sch]

Parts:
C81, C82, C83, C84, C85: 100n; C0603
D12: BAS316; SOD323-W
FB4, FB5, FB6: 60R@100MHz; BEAD0603
IC15: TPD4E002DRL; DRL5
IC16: TPD2E001DZDR; SOP192P292X122-4N
IC17: ADUM3160BRWZ; SOIC-16W
JP9, JP10: ZL303-03P
K_DOUT1: RT424005; RT-C_016A5_ROUND
Q25: 2N7002; SOT103P240X110-3N
R123: 100K; R0805
R124, R125: 22R; R0805
VAR3, VAR4: ERZE11A431; VARISTOR_13MM
X5: 09185067324; IDC-10PIN
X6: CTB9300/3A + CTB92VG/3S; WR-TBL_3-PIN
X7: Amphenol: LMJ2138812S0LOT6C or WE: 74990101210; RJ45-VERT
X8: 826629-8; HEADER_8-PIN
X9, X10: 826629-5; SSW-105-02-S-S
X11: 2411-01; KUSBVX-BS1N
ZD6: SMAJ18A; DO214AC
ZD17: PDZ5.6B; SOD323-W

Connections:
+5V: C81.1, D12.C, IC17.16 (VBUS2), K_DOUT1.A1 (C2)
AC_EARTH: FB6.P$1 (1), X7.8 (SH), X7.SH1 (SH), X7.SH2 (SH), X9.1, X11.M1 (S1), X11.M2 (S2)
AUX_+3V3: FB4.P$2 (2), X8.1
AUX_ETH_ACTLED: X7.10 (YELLOW-C), X8.1
AUX_ETH_IN+: IC15.4 (IO3), X7.3 (RD+), X8.1
AUX_ETH_IN-: IC15.5 (IO4), X7.6 (RD-), X8.1
AUX_ETH_LINKLED: X7.12 (GREEN-C), X8.1
AUX_ETH_OUT+: IC15.3 (IO2), X7.2 (TD-), X8.1
AUX_ETH_OUT-: IC15.1 (IO1), X7.1 (TD+), X8.1
D+: IC16.2 (IO1), R125.1, X9.1, X11.3
D-: IC16.3 (IO2), R124.1, X9.1, X11.2
GND: C81.2, C84.2, IC15.2 (GND), IC17.9 (GND2), IC17.15 (GND2_2), JP9.3, Q25.2 (S), R123.1, X10.1
unnamed: C82.1, FB5.P$2 (2), IC17.1 (VBUS1)
unnamed: C84.1, IC17.12 (PIN), IC17.14 (VDD2), JP9.1
unnamed: C85.1, IC17.3 (VDD1), IC17.4 (PDEN), JP10.1
unnamed: D12.A, ZD6.A
unnamed: FB4.P$1 (1), X7.4 (CT), X7.9 (YELLOW_A), X7.11 (GREEN-A)
unnamed: IC17.5 (SPU), JP10.2
unnamed: IC17.6 (UD-), R124.2
unnamed: IC17.7 (UD+), R125.2
unnamed: IC17.10 (DD+), X10.1
unnamed: IC17.11 (DD-), X10.1
unnamed: IC17.13 (SPD), JP9.2
unnamed: K_DOUT1.A2 (C1), Q25.3 (D), ZD6.C
unnamed: Q25.1 (G), R123.2, X5.1
unnamed: VAR3.1, VAR4.1, X6.1
unnamed: VAR3.2, X6.1
unnamed: VAR4.2, X6.1
XUSB_GND: C82.2, C83.1, C85.2, FB6.P$2 (2), IC16.1 (GND), IC17.2 (GND1_2), IC17.8 (GND1), JP10.3, X9.1, X11.4, ZD17.A
XUSB_VBUS: C83.2, FB5.P$1 (1), IC16.4 (VCC), X11.1, ZD17.C

Notes on the sheet:
Licensed under the TAPR Open Hardware License (www.tapr.org/OHL)
More info at http://www.envox.hr/eez
Repository: https://github.com/eez-open
Ethernet connector with optional surge protection
USB connector with optional isolator and surge protection
Note 7.1: Mount X4 and X8 on the opposite (top) side of the PCB. Use 14 mm (e.g. Bossard B3X14/BN3320) for enclosure with 3 mm rear panel
USB speed
High
Low
JP9, JP10
1-2
2-3
8-pin connector X8
5-pin connector X9, X10
LED Link (Input) 1
LED Act (Input) 2
Shield 3
RX+ (Output) 4
RX- (Output) 5
TX+ (Input) 6
TX- (Input) 7
+3.3V (Input) 8
Digital OUT2 relay
Vcc 1
Data- 2
Data+ 3
Gnd 4
Shield 5
NO contact 1
Common 2
NC contact 3
3-pin connector X6
