koson/psu-hw/Consolidated/KiCad/Isolators,_Arduino.kicad_sch

## KiCad design Consolidated/KiCad/Isolators,_Arduino.kicad_sch (2021-06-04)

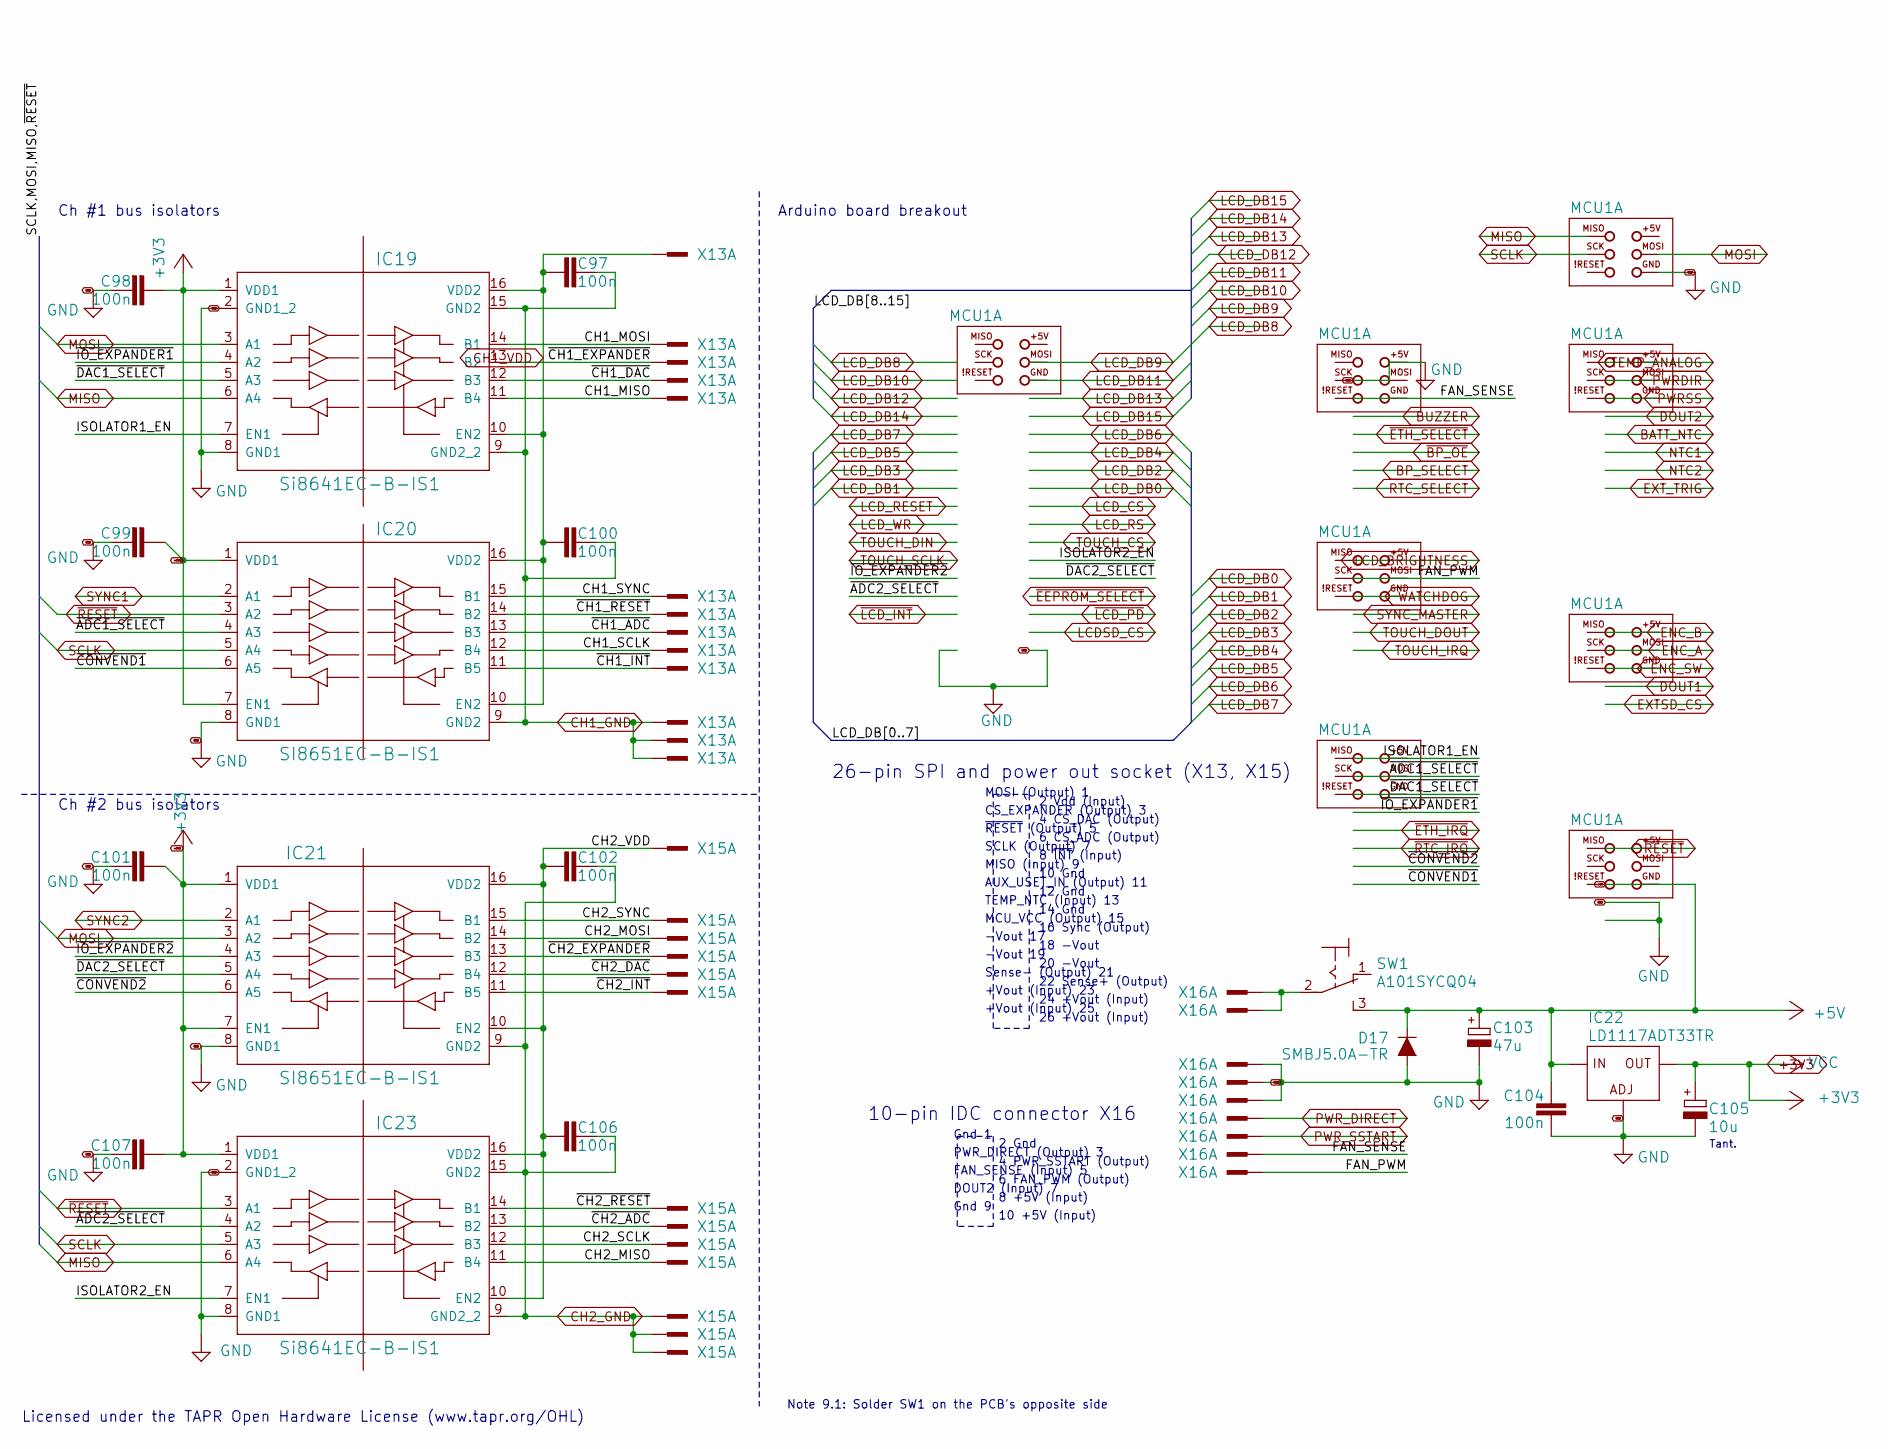
[picture p8: schematic Isolators,_Arduino.kicad_sch]

Parts:
C97, C98, C99, C100, C101, C102, C104, C106, C107: 100n; C0603
C103: 47u; CAPAE660X610N
C105: 10u; EC1206
D17: SMBJ5.0A-TR; DO214AA
IC19, IC23: Si8641EC-B-IS1; SOIC-16
IC20, IC21: SI8651EC-B-IS1; SOIC-16
IC22: LD1117ADT33TR; SOT223
MCU1: Arduino Due; ARDUINO+ICSP_MIRROR
SW1: A101SYCQ04; M9040P
X13, X15: TSW-113-07-F-D
X16: 09185067324; IDC-10PIN

Connections:
+3V3: C98.1, C99.1, C101.1, C105.+, C107.1, IC19.1 (VDD1), IC20.1 (VDD1), IC20.7 (EN1), IC21.1 (VDD1), IC21.7 (EN1), IC22.4 (OUT), IC23.1 (VDD1)
+5V: C103.1 (+), C104.1, D17.C, IC22.3 (IN), SW1.3 (S)
CH1_GND: C97.2, C100.2, IC19.9 (GND2_2), IC19.15 (GND2), IC20.9 (GND2), X13.1
CH1_MISO: IC19.11 (B4), X13.1
CH1_MOSI: IC19.14 (B1), X13.1
CH1_SCLK: IC20.12 (B4), X13.1
CH1_SYNC: IC20.15 (B1), X13.1
CH1_VDD: C97.1, C100.1, IC19.10 (EN2), IC19.16 (VDD2), IC20.10 (EN2), IC20.16 (VDD2), X13.1
CH2_GND: C102.2, C106.2, IC21.9 (GND2), IC23.9 (GND2_2), IC23.15 (GND2), X15.1
CH2_MISO: IC23.11 (B4), X15.1
CH2_MOSI: IC21.14 (B2), X15.1
CH2_SCLK: IC23.12 (B3), X15.1
CH2_SYNC: IC21.15 (B1), X15.1
CH2_VDD: C102.1, C106.1, IC21.10 (EN2), IC21.16 (VDD2), IC23.10 (EN2), IC23.16 (VDD2), X15.1
FAN_PWM: X16.1
FAN_SENSE: X16.1
GND: C98.2, C99.2, C101.2, C103.2 (-), C104.2, C105.-, C107.2, D17.A, IC19.2 (GND1_2), IC19.8 (GND1), IC20.8 (GND1), IC21.8 (GND1), IC22.1 (ADJ), IC23.2 (GND1_2), IC23.8 (GND1), MCU1.ICSP_GND (GND), X16.1
ISOLATOR1_EN: IC19.7 (EN1)
ISOLATOR2_EN: IC23.7 (EN1)
MISO: IC19.6 (A4), IC23.6 (A4), MCU1.ICSP_MISO (MISO)
MOSI: IC19.3 (A1), IC21.3 (A2), MCU1.ICSP_MOSI (MOSI)
unnamed: SW1.2, X16.1
PWR_DIRECT: X16.1
PWR_SSTART: X16.1
SCLK: IC20.5 (A4), IC23.5 (A3), MCU1.ICSP_SCK (SCK)
SYNC1: IC20.2 (A1)
SYNC2: IC21.2 (A1)
~ADC1_SELECT: IC20.4 (A3)
~ADC2_SELECT: IC23.4 (A2)
~CH1_ADC: IC20.13 (B3), X13.1
~CH1_DAC: IC19.12 (B3), X13.1
~CH1_EXPANDER: IC19.13 (B2), X13.1
~CH1_INT: IC20.11 (B5), X13.1
~CH1_RESET: IC20.14 (B2), X13.1
~CH2_ADC: IC23.13 (B2), X15.1
~CH2_DAC: IC21.12 (B4), X15.1
~CH2_EXPANDER: IC21.13 (B3), X15.1
~CH2_INT: IC21.11 (B5), X15.1
~CH2_RESET: IC23.14 (B1), X15.1
~CONVEND1: IC20.6 (A5)
~CONVEND2: IC21.6 (A5)
~DAC1_SELECT: IC19.5 (A3)
~DAC2_SELECT: IC21.5 (A4)
~IO_EXPANDER1: IC19.4 (A2)
~IO_EXPANDER2: IC21.4 (A3)
~RESET: IC20.3 (A2), IC23.3 (A1)

Notes on the sheet:
Licensed under the TAPR Open Hardware License (www.tapr.org/OHL)
Ch #1 bus isolators
Ch #2 bus isolators
Arduino board breakout
Note 9.1: Solder SW1 on the PCB's opposite side
26-pin SPI and power out socket (X13, X15)
10-pin IDC connector X16
Gnd 1
PWR_DIRECT (Output) 3
FAN_SENSE (Input) 5
DOUT2 (Input) 7
Gnd 9
MOSI (Output) 1
CS_EXPANDER (Output) 3
~RESET~ (Output) 5
SCLK (Output) 7
MISO (Input) 9
AUX_USET_IN (Output) 11
TEMP_NTC (Input) 13
MCU_VCC (Output) 15
-Vout 17
-Vout 19
Sense- (Output) 21
+Vout (Input) 23
+Vout (Input) 25
2 Gnd
4 PWR_SSTART (Output)
6 FAN_PWM (Output)
8 +5V (Input)
10 +5V (Input)
2 Vdd (Input)
4 CS_DAC (Output)
6 CS_ADC (Output)
8 ~INT~ (Input)
10 Gnd
12 Gnd
14 Gnd
16 Sync (Output)
18 -Vout
20 -Vout
22 Sense+ (Output)
24 +Vout (Input)
26 +Vout (Input)
Tant.
