koson/psu-hw/Consolidated/KiCad/Post-regulator.kicad_sch

## KiCad design Consolidated/KiCad/Post-regulator.kicad_sch (2021-06-04)

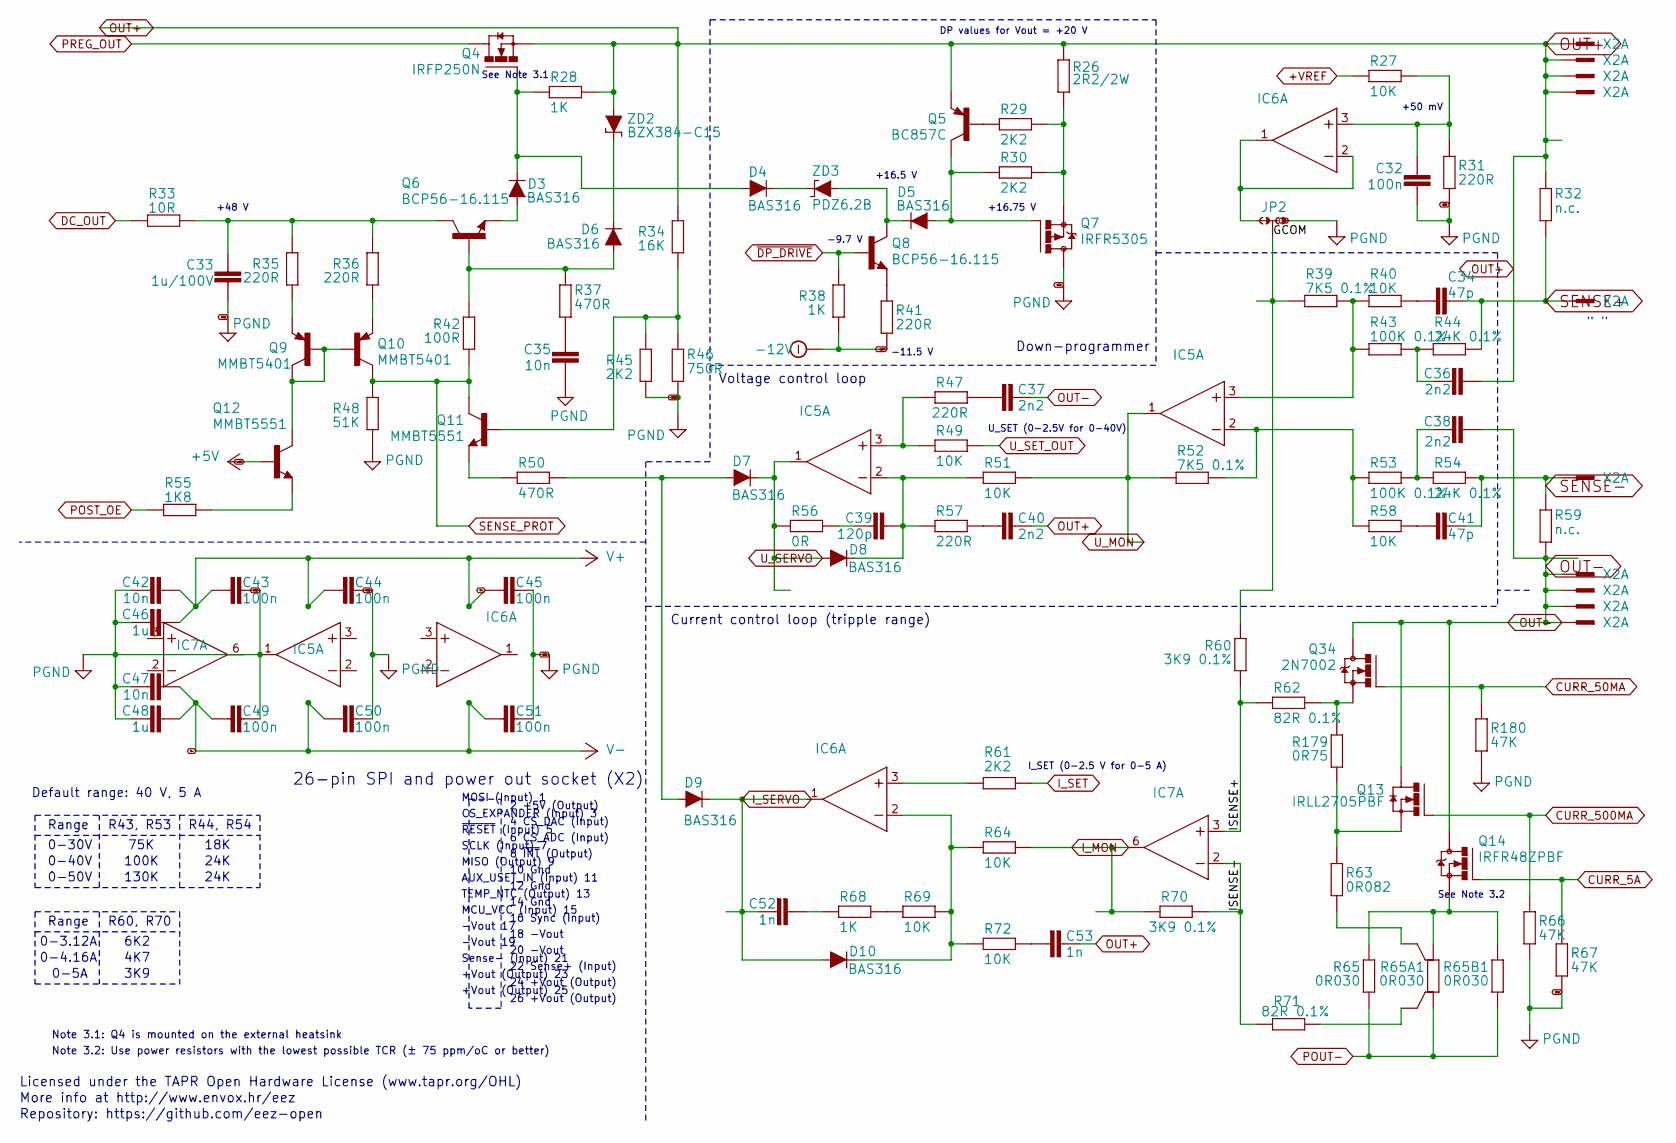
[picture p9: schematic Post-regulator.kicad_sch]

Parts:
C32, C43, C44, C45, C49, C50, C51: 100n; C0603
C33: 1u/100V; C1206
C34, C41: 47p; C0805
C35, C42, C47: 10n; C0805
C36, C37, C38, C40: 2n2; C0805
C39: 120p; C0805
C46, C48: 1u; C0805
C52, C53: 1n; C0805
D3, D4, D5, D6, D7, D8, D9, D10: BAS316; SOD323-R
IC5, IC6: TL072D; SOIC127P600X173-8N
IC7: LTC2050HVCS8#PBF; SOIC127P600X173-8N
JP2: JP3-CUT
Q4: IRFP250N; TO247BH-CLR
Q5: BC857C; SOT23-BEC
Q6, Q8: BCP56-16.115; SOT230P700X180-4N
Q7: IRFR5305; TO229P990X239-3N
Q9, Q10: MMBT5401; SOT23-BEC
Q11, Q12: MMBT5551; SOT23-BEC
Q13: IRLL2705PBF; SOT223
Q14: IRFR48ZPBF; TO229P990X239-3N
Q34: 2N7002; SOT103P240X110-3N
R26: 2R2/2W; R2512
R27, R40, R49, R51, R58, R64, R69, R72: 10K; R0805
R28, R38, R68: 1K; R0805
R29, R30, R45, R61: 2K2; R0805
R31, R35, R36, R41, R47, R57: 220R; R0805
R32, R59: n.c.; R0805
R33: 10R; R1206
R34: 16K; R0805
R37, R50: 470R; R0805
R39, R52: 7K5 0.1%; R0805
R42: 100R; R0805
R43, R53: 100K 0.1%; R0805
R44, R54: 24K 0.1%; R0805
R46: 750R; R0805
R48: 51K; R0805
R55: 1K8; R0805
R56: 0R; R0805
R60, R70: 3K9 0.1%; R0805
R62, R71: 82R 0.1%; R0805
R63: 0R082; R1210
R65, R65B1: 0R030; R2512
R65A1: 0R030; R_2512-4WIRE
R66, R67, R180: 47K; R0805
R179: 0R75; R1206
X2: SSW-113-02-T-D-RA
ZD2: BZX384-C15; SOD323-W
ZD3: PDZ6.2B; SOD323-W

Connections:
+5V: Q12.B
+VREF: R27.1
-12V: R38.2, R41.2
CURR_5A: Q14.1 (G), R67.2
CURR_50MA: Q34.1 (G), R180.2
CURR_500MA: Q13.1 (G), R66.2
DC_OUT: R33.1
GCOM: JP2.COM, R39.1, R60.1
GND: C32.2, C33.2, C35.2, C42.1, C43.2, C44.1, C45.1, C46.1, C47.1, C48.1, C49.2, C50.1, C51.1, IC5.1 (OUT), JP2.NO, Q7.2 (D), R31.2, R45.1, R46.1, R48.1, R66.1, R67.1, R180.1
ISENSE+: IC7.3 (+IN), R60.2, R62.2
ISENSE-: IC7.2 (-IN), R70.1, R71.2
I_MON: IC7.6 (OUT), R64.1, R70.2
I_SERVO: C52.2, D9.C, D10.A, IC6.1 (OUT)
I_SET: R61.1
unnamed: C32.1, IC6.3 (+IN), R27.2, R31.1
unnamed: C33.1, Q6.2 (C), Q6.4 (C), R33.2, R35.2, R36.2
unnamed: C34.2, R40.1
unnamed: C35.1, R37.1
unnamed: C36.1, R43.2, R44.1
unnamed: C37.2, R47.1
unnamed: C38.1, R53.2, R54.1
unnamed: C39.1, D8.C, IC5.2 (-IN), R51.2, R57.2
unnamed: C39.2, R56.1
unnamed: C40.2, R57.1
unnamed: C41.2, R58.1
unnamed: C52.1, R68.1
unnamed: C53.2, R72.1
unnamed: D3.A, Q6.3 (E)
unnamed: D3.C, D4.A, Q4.G, R28.1
unnamed: D4.C, ZD3.C
unnamed: D5.A, Q5.C, Q7.1 (G), R30.2
unnamed: D5.C, Q8.2 (C), Q8.4 (C), ZD3.A
unnamed: D6.A, Q6.1 (B), R37.2, R42.1
unnamed: D6.C, ZD2.C
unnamed: D7.A, D9.A, R50.1
unnamed: D10.C, IC6.2 (-IN), R64.2, R69.2, R72.2
unnamed: IC5.2 (-IN), R52.2, R53.1, R58.2
unnamed: IC5.3 (+IN), R39.2, R40.2, R43.1, R47.2, R49.2
unnamed: IC6.1 (OUT), IC6.2 (-IN), JP2.NC
unnamed: IC6.3 (+IN), R61.2
unnamed: Q5.B, R29.2
unnamed: Q7.3 (S), R26.1, R29.1, R30.1
unnamed: Q8.3 (E), R41.1
unnamed: Q9.E, R35.1
unnamed: Q9.B, Q9.C, Q10.B, Q12.C
unnamed: Q10.E, R36.1
unnamed: Q11.B, R34.1, R45.2, R46.2
unnamed: Q11.E, R50.2
unnamed: Q12.E, R55.2
unnamed: Q13.3 (S), R63.2, R179.2
unnamed: Q14.3 (S), R65.2, R65A1.2, R65B1.2
unnamed: Q34.2 (S), R62.1, R179.1
unnamed: R63.1, R65A1.2S
unnamed: R65A1.1S, R71.1
unnamed: R68.2, R69.1
OUT+: C36.2, C40.1, C53.1, Q4.S, Q5.E, R26.2, R28.2, R32.1, R34.2, X2.1, ZD2.A
OUT-: C37.1, C38.2, Q13.2 (D), Q13.4 (D), Q14.2 (D), Q34.3 (D), R59.2, X2.1
POST_OE: R55.1
POUT-: R65.1, R65A1.1, R65B1.1
PREG_OUT: Q4.D
SENSE+: C34.1, R32.2, R44.2, X2.1
SENSE-: C41.1, R54.2, R59.1, X2.1
SENSE_PROT: Q10.C, Q11.C, R42.2, R48.2
U_MON: IC5.1 (OUT), R51.1, R52.1
U_SERVO: D7.C, D8.A, IC5.1 (OUT), R56.2
U_SET_OUT: R49.1
V+: C42.2, C43.1, C44.2, C45.2, C46.2
V-: C47.2, C48.2, C49.1, C50.2, C51.2
~DP_DRIVE: Q8.1 (B), R38.1

Notes on the sheet:
Licensed under the TAPR Open Hardware License (www.tapr.org/OHL)
More info at http://www.envox.hr/eez
Repository: https://github.com/eez-open
Default range: 40 V, 5 A
0-3.12A
0-4.16A
Range
0-30V
0-40V
0-50V
0-5A
Note 3.1: Q4 is mounted on the external heatsink
Note 3.2: Use power resistors with the lowest possible TCR (± 75 ppm/oC or better)
R43, R53
R60, R70
100K
130K
6K2
4K7
3K9
75K
R44, R54
18K
24K
+48 V
26-pin SPI and power out socket (X2)
MOSI (Input) 1
CS_EXPANDER (Input) 3
~RESET~ (Input) 5
SCLK (Input) 7
MISO (Output) 9
AUX_USET_IN (Input) 11
TEMP_NTC (Output) 13
MCU_VCC (Input) 15
-Vout 17
-Vout 19
Sense- (Input) 21
+Vout (Output) 23
+Vout (Output) 25
See Note 3.1
2 +5V (Output)
4 CS_DAC (Input)
6 CS_ADC (Input)
8 ~INT~ (Output)
10 Gnd
12 Gnd
14 Gnd
16 Sync (Input)
18 -Vout
20 -Vout
22 Sense+ (Input)
24 +Vout (Output)
26 +Vout (Output)
Current control loop (tripple range)
Voltage control loop
-9.7 V
+16.5 V
-11.5 V
DP values for Vout = +20 V
+16.75 V
U_SET (0-2.5V for 0-40V)
Down-programmer
I_SET (0-2.5 V for 0-5 A)
+50 mV
See Note 3.2
" "
