koson/psu-hw/Consolidated/KiCad/Power_pre-regulator.kicad_sch

## KiCad design Consolidated/KiCad/Power_pre-regulator.kicad_sch (2021-06-04)

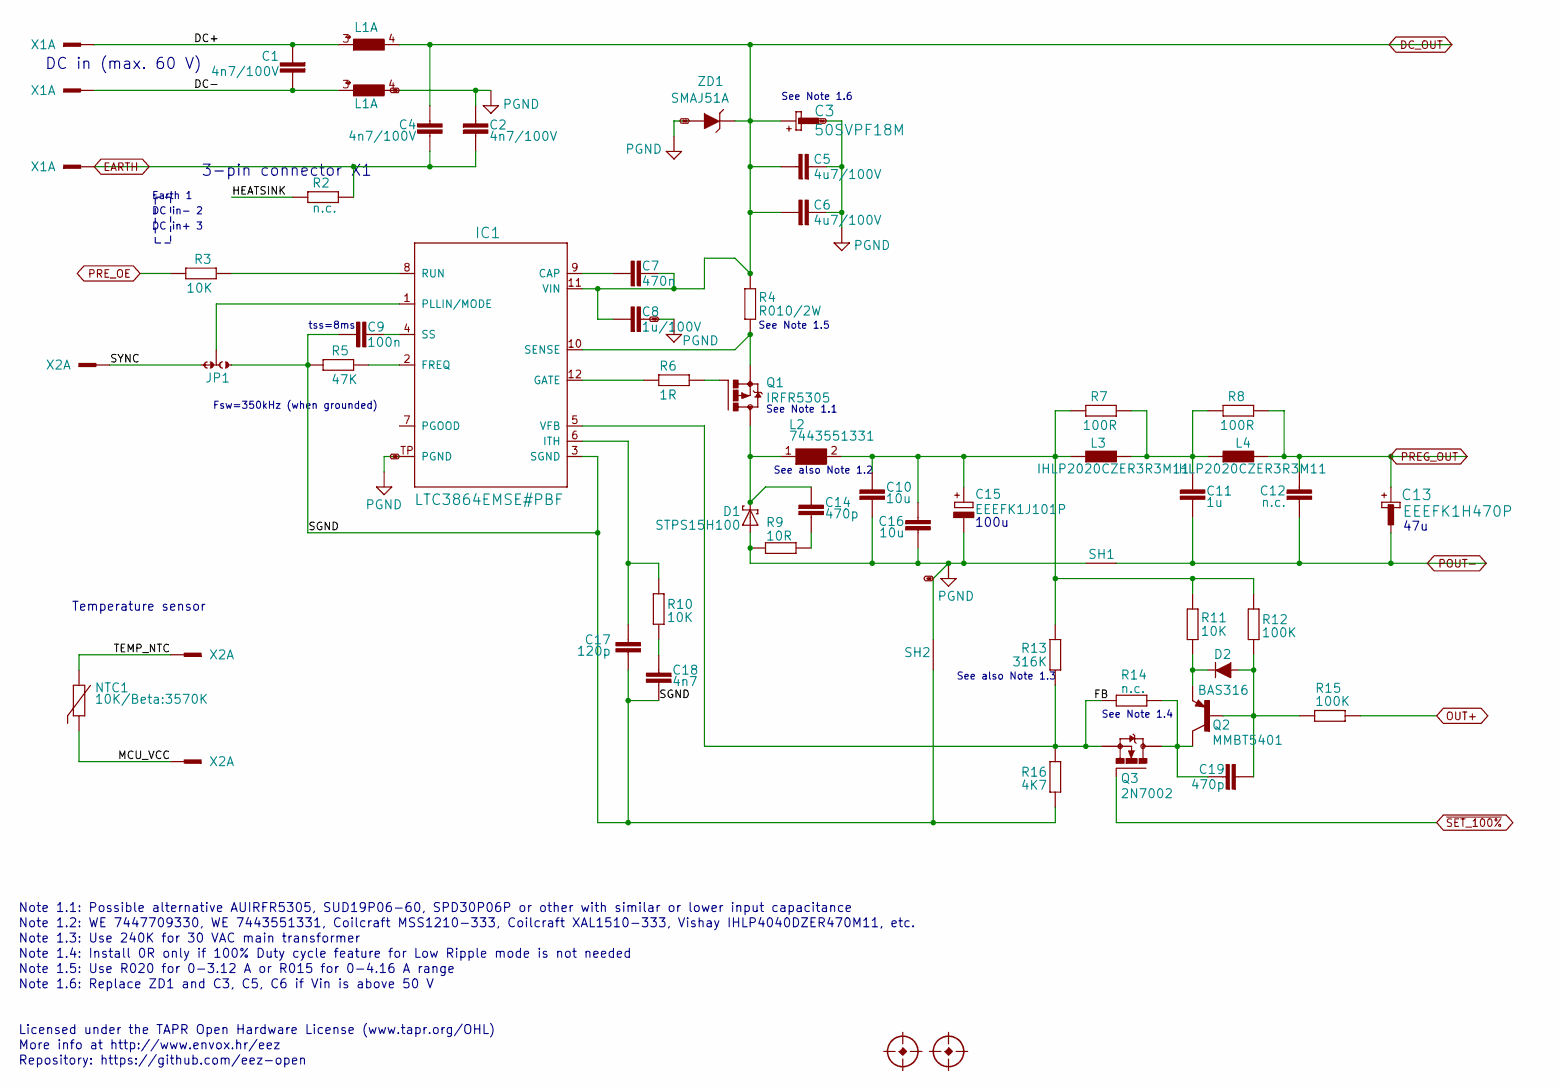
[picture p10: schematic Power_pre-regulator.kicad_sch]

Parts:
C1, C2, C4: 4n7/100V; C1206
C3: 50SVPF18M; CAPAE830X650N
C5, C6: 4u7/100V; C1210
C7: 470n; C0805
C8: 1u/100V; C1206
C9: 100n; C0603
C10, C16: 10u; C1210
C11: 1u; C0805
C12: n.c.; C0805
C13: EEEFK1H470P; CAPAE830X1050N
C14, C19: 470p; C0805
C15: EEEFK1J101P; PANASONIC_F
C17: 120p; C0805
C18: 4n7; C0805
D1: STPS15H100; TO252
D2: BAS316; SOD323-R
FM1, FM2: FIDUCIAL_2; FIDUCIAL_DUAL
IC1: LTC3864EMSE#PBF; LTC_05-08-1666
JP1: JP3-CUT
L1: RN112-4-02; RN112
L2: 7443551331; WE-HCI_1350_1365
L3, L4: IHLP2020CZER3R3M11; IHLP-2020BZ-11
NTC1: 10K/Beta:3570K; R_0204_5+0805
Q1: IRFR5305; TO229P990X239-3N
Q2: MMBT5401; SOT23-BEC
Q3: 2N7002; SOT103P240X110-3N
R2, R14: n.c.; R0805
R3, R10, R11: 10K; R0805
R4: R010/2W; R2512
R5: 47K; R0805
R6: 1R; R0805
R7, R8: 100R; R0805
R9: 10R; R1206
R12, R15: 100K; R0805
R13: 316K; R0805
R16: 4K7; R0805
SH1: Pgnd to Pout- short; SHORT_NOHOLE
SH2: Sgnd to Pgnd short; SHORT_NOHOLE
X1: 39-30-1039; MINIFIT_39301039
X2: SSW-113-02-T-D-RA
ZD1: SMAJ51A; DO214AA

Connections:
DC+: C1.2, L1.3 (1), X1.2
DC-: C1.1, L1.3 (1), X1.2
DC_OUT: C3.1, C4.2, C5.1, C6.1, C7.2, C8.1, IC1.11 (VIN), L1.4 (2), R4.1, ZD1.C
EARTH: C2.2, C4.1, R2.2, X1.2
FB: IC1.5 (VFB), Q3.2 (S), R13.2, R14.2, R16.1
GND: C2.1, C3.2, C5.2, C6.2, C8.2, C10.2, C15.2 (-), C16.2, D1.1 (A), D1.2 (A), IC1.TP (PGND), L1.4 (2), R9.1, SH1.P$2 (GND_B), SH2.P$2 (GND_B), ZD1.A
HEATSINK: R2.1
MCU_VCC: NTC1.2, NTC1.2.1, X2.1
unnamed: C7.1, IC1.9 (CAP)
unnamed: C9.2, IC1.4 (SS)
unnamed: C10.1, C15.1 (+), C16.1, L2.2, L3.1, R7.1, R11.1, R12.1, R13.1
unnamed: C11.1, L3.2, L4.1, R7.2, R8.1
unnamed: C14.1, D1.3 (C), L2.1, Q1.2 (D)
unnamed: C14.2, R9.2
unnamed: C17.1, IC1.6 (ITH), R10.2
unnamed: C18.1, R10.1
unnamed: C19.1, Q2.C, Q3.3 (D), R14.1
unnamed: C19.2, D2.A, Q2.B, R12.2, R15.1
unnamed: D2.C, Q2.E, R11.2
unnamed: IC1.1 (PLLIN/MODE), JP1.COM
unnamed: IC1.2 (FREQ), R5.1
unnamed: IC1.8 (RUN), R3.1
unnamed: IC1.10 (SENSE), Q1.3 (S), R4.2
unnamed: IC1.12 (GATE), R6.1
unnamed: Q1.1 (G), R6.2
OUT+: R15.2
POUT-: C11.2, C12.2, C13.2, SH1.P$1 (GND_A)
PREG_OUT: C12.1, C13.1, L4.2, R8.2
PRE_OE: R3.2
SGND: C9.1, C17.2, C18.2, IC1.3 (SGND), JP1.NO, R5.2, R16.2, SH2.P$1 (GND_A)
SYNC: JP1.NC, X2.1
TEMP_NTC: NTC1.1, NTC1.1.1, X2.1
~SET_100%: Q3.1 (G)

Notes on the sheet:
Note 1.1: Possible alternative AUIRFR5305, SUD19P06-60, SPD30P06P or other with similar or lower input capacitance
Note 1.2: WE 7447709330, WE 7443551331, Coilcraft MSS1210-333, Coilcraft XAL1510-333, Vishay IHLP4040DZER470M11, etc.
Note 1.3: Use 240K for 30 VAC main transformer
Note 1.4: Install 0R only if 100% Duty cycle feature for Low Ripple mode is not needed
Note 1.5: Use R020 for 0-3.12 A or R015 for 0-4.16 A range
Note 1.6: Replace ZD1 and C3, C5, C6 if Vin is above 50 V
Licensed under the TAPR Open Hardware License (www.tapr.org/OHL)
More info at http://www.envox.hr/eez
Repository: https://github.com/eez-open
DC in (max. 60 V)
Temperature sensor
Earth 1
DC in- 2
DC in+ 3
3-pin connector X1
Fsw=350kHz (when grounded)
tss=8ms
See Note 1.5
See Note 1.1
See also Note 1.2
See Note 1.6
See also Note 1.3
100u
See Note 1.4
47u
