koson/psu-hw/Consolidated/KiCad/Reset,_load_temp,_digital_input.kicad_sch

## KiCad design Consolidated/KiCad/Reset,_load_temp,_digital_input.kicad_sch (2021-06-04)

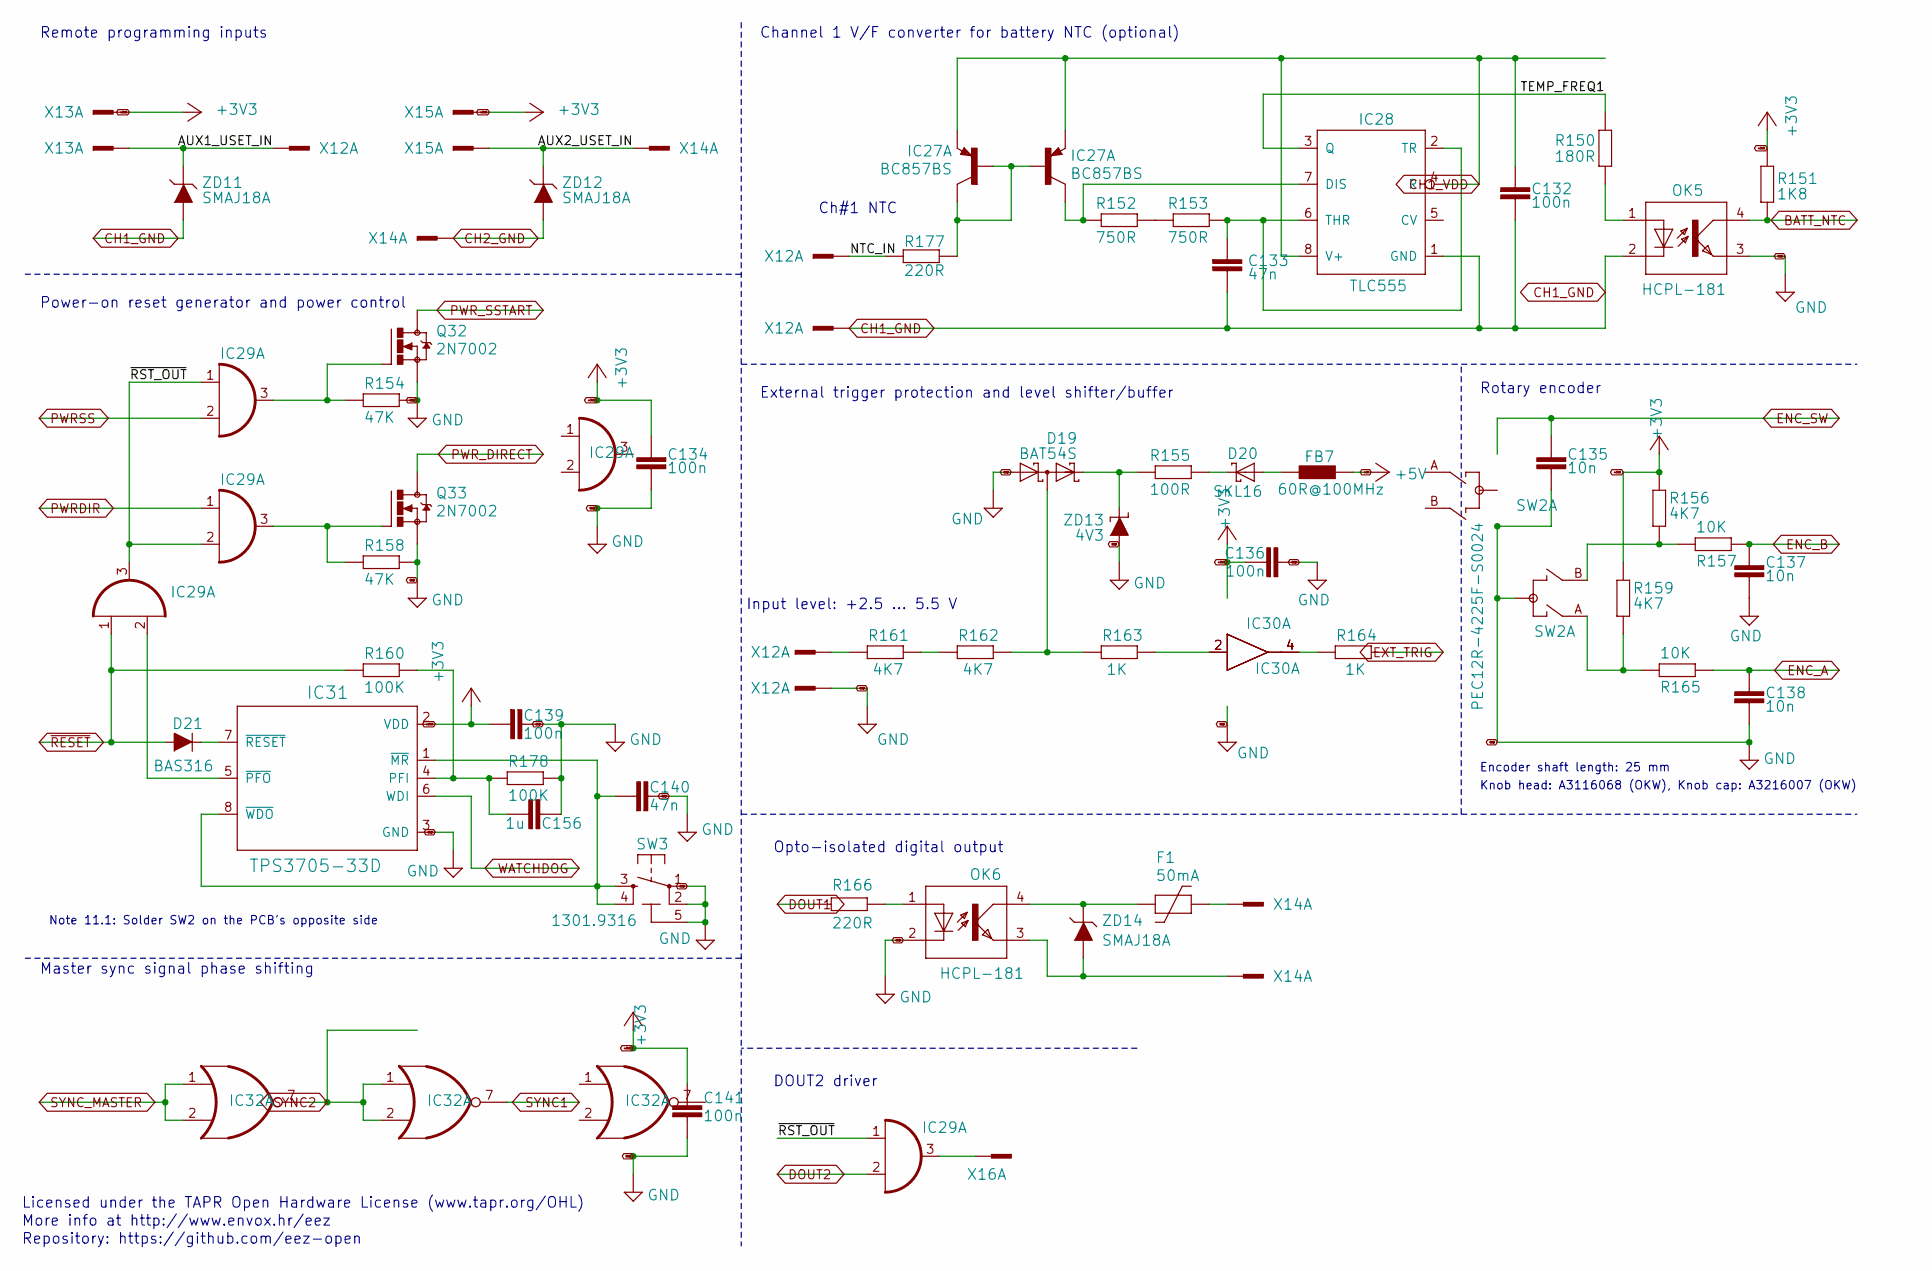
[picture p11: schematic Reset,_load_temp,_digital_input.kicad_sch]

Parts:
C132, C134, C136, C139, C141: 100n; C0603
C133, C140: 47n; C0805
C135, C137, C138: 10n; C0805
C156: 1u; C0805
D19: BAT54S; SOT23
D20: SKL16; SOD123
D21: BAS316; SOD323-R
F1: 50mA; F1210
FB7: 60R@100MHz; BEAD0603
IC27: BC857BS; SOT65P210X110-6N
IC28: TLC555; SOIC127P600X175-8N
IC29: SN74LVC08APWR; SOP65P640X120-14N
IC30: SN74LV1T34DBVR; SOT95P280X145-5N
IC31: TPS3705-33D; SOIC127P600X175-8N
IC32: SN74LVC2G02DCTR; SOP65P400X130-8N
OK5, OK6: HCPL-181
Q32, Q33: 2N7002; SOT103P240X110-3N
R150: 180R; R0805
R151: 1K8; R0805
R152, R153: 750R; R0805
R154, R158: 47K; R0805
R155: 100R; R0805
R156, R159, R161, R162: 4K7; R0805
R157, R165: 10K; R0805
R160, R178: 100K; R0805
R163, R164: 1K; R0805
R166, R177: 220R; R0805
SW2: PEC12R-4225F-S0024; EC12E_SW
SW3: 1301.9316; TACTM-6XN
X12, X14: MC000006; MC000006_MIRROR
X13, X15: TSW-113-07-F-D
X16: 09185067324; IDC-10PIN
ZD11, ZD12, ZD14: SMAJ18A; DO214AC
ZD13: 4V3; MINIMELF

Connections:
+3V3: C134.2, C136.1, C139.2, C141.1, IC31.2 (VDD), R151.1, R156.1, R159.1, X13.1, X15.1
+5V: FB7.P$1 (1)
AUX1_USET_IN: X12.1, X12.1.1, X13.1, ZD11.C
AUX2_USET_IN: X14.1, X14.1.1, X15.1, ZD12.C
BATT_NTC: OK5.4 (COL), R151.2
CH1_GND: C132.2, C133.1, IC28.1 (GND), OK5.2 (C), X12.1, X12.1.1, ZD11.A
CH1_VDD: C132.1, IC27.1 (E), IC28.4 (R), IC28.8 (V+)
CH2_GND: X14.1, X14.1.1, ZD12.A
DOUT1: R166.1
DOUT2: IC29.2 (I1)
ENC_A: C138.1, R165.1
ENC_B: C137.2, R157.1
ENC_SW: C135.2
EXT_TRIG: R164.1
GND: C134.1, C135.1, C136.2, C137.1, C138.2, C139.1, C140.1, C141.2, C156.2, D19.1 (A1), IC31.3 (GND), OK5.3 (EMIT), OK6.2 (C), Q32.2 (S), Q33.2 (S), R154.2, R158.2, R178.2, SW2.C, SW2.GND1 (C), SW2.GND2 (C), SW3.1, SW3.2, SW3.5 (5-GND), X12.1, X12.1.1, ZD13.A
NTC_IN: R177.1, X12.1, X12.1.1
unnamed: C133.2, IC28.2 (TR), IC28.6 (THR), R153.2
unnamed: C140.2, IC31.1 (~MR), IC31.8 (~WDO), SW3.3, SW3.4
unnamed: C156.1, IC31.4 (PFI), R160.2, R178.1
unnamed: D19.2 (C2), R155.1, ZD13.C
unnamed: D19.3 (C1A2), R162.1, R163.2
unnamed: D20.A, FB7.P$2 (2)
unnamed: D20.C, R155.2
unnamed: D21.C, IC31.7 (~RESET)
unnamed: F1.1, OK6.4 (COL), ZD14.C
unnamed: F1.2, X14.1, X14.1.1
unnamed: IC27.2 (B), IC27.6 (C), R177.2
unnamed: IC27.6 (C), IC28.7 (DIS), R152.1
unnamed: IC29.2 (I1), IC31.5 (~PFO)
unnamed: IC29.3 (O), Q32.1 (G), Q33.1 (G), R154.1, R158.1, X16.1
unnamed: IC30.2 (I), R163.1
unnamed: IC30.4 (O), R164.2
unnamed: OK5.1 (A), R150.2
unnamed: OK6.1 (A), R166.2
unnamed: OK6.3 (EMIT), X14.1, X14.1.1, ZD14.A
unnamed: R152.2, R153.1
unnamed: R156.2, R157.2, SW2.B
unnamed: R159.2, R165.2, SW2.A
unnamed: R161.1, R162.2
unnamed: R161.2, X12.1, X12.1.1
unnamed: SW2.C, SW2.GND1 (C), SW2.GND2 (C)
PWRDIR: IC29.1 (I0)
PWRSS: IC29.2 (I1)
PWR_DIRECT: Q33.3 (D)
PWR_SSTART: Q32.3 (D)
SYNC1: IC32.7 (O)
SYNC2: IC32.1 (I0), IC32.2 (I1), IC32.7 (O)
SYNC_MASTER: IC32.1 (I0), IC32.2 (I1)
TEMP_FREQ1: IC28.3 (Q), R150.1
WATCHDOG: IC31.6 (WDI)
~RESET: D21.A, IC29.1 (I0), R160.1
~RST_OUT: IC29.1 (I0), IC29.2 (I1), IC29.3 (O)

Notes on the sheet:
Licensed under the TAPR Open Hardware License (www.tapr.org/OHL)
More info at http://www.envox.hr/eez
Repository: https://github.com/eez-open
Remote programming inputs
Power-on reset generator and power control
Master sync signal phase shifting
Note 11.1: Solder SW2 on the PCB's opposite side
Input level: +2.5 ... 5.5 V
Channel 1 V/F converter for battery NTC (optional)
External trigger protection and level shifter/buffer
Opto-isolated digital output
DOUT2 driver
Ch#1 NTC
Rotary encoder
Encoder shaft length: 25 mm
Knob head: A3116068 (OKW), Knob cap: A3216007 (OKW)
