koson/psu-hw/Consolidated/KiCad/SPI_peripherals,_TFT_display.kicad_sch

## KiCad design Consolidated/KiCad/SPI_peripherals,_TFT_display.kicad_sch (2021-06-04)

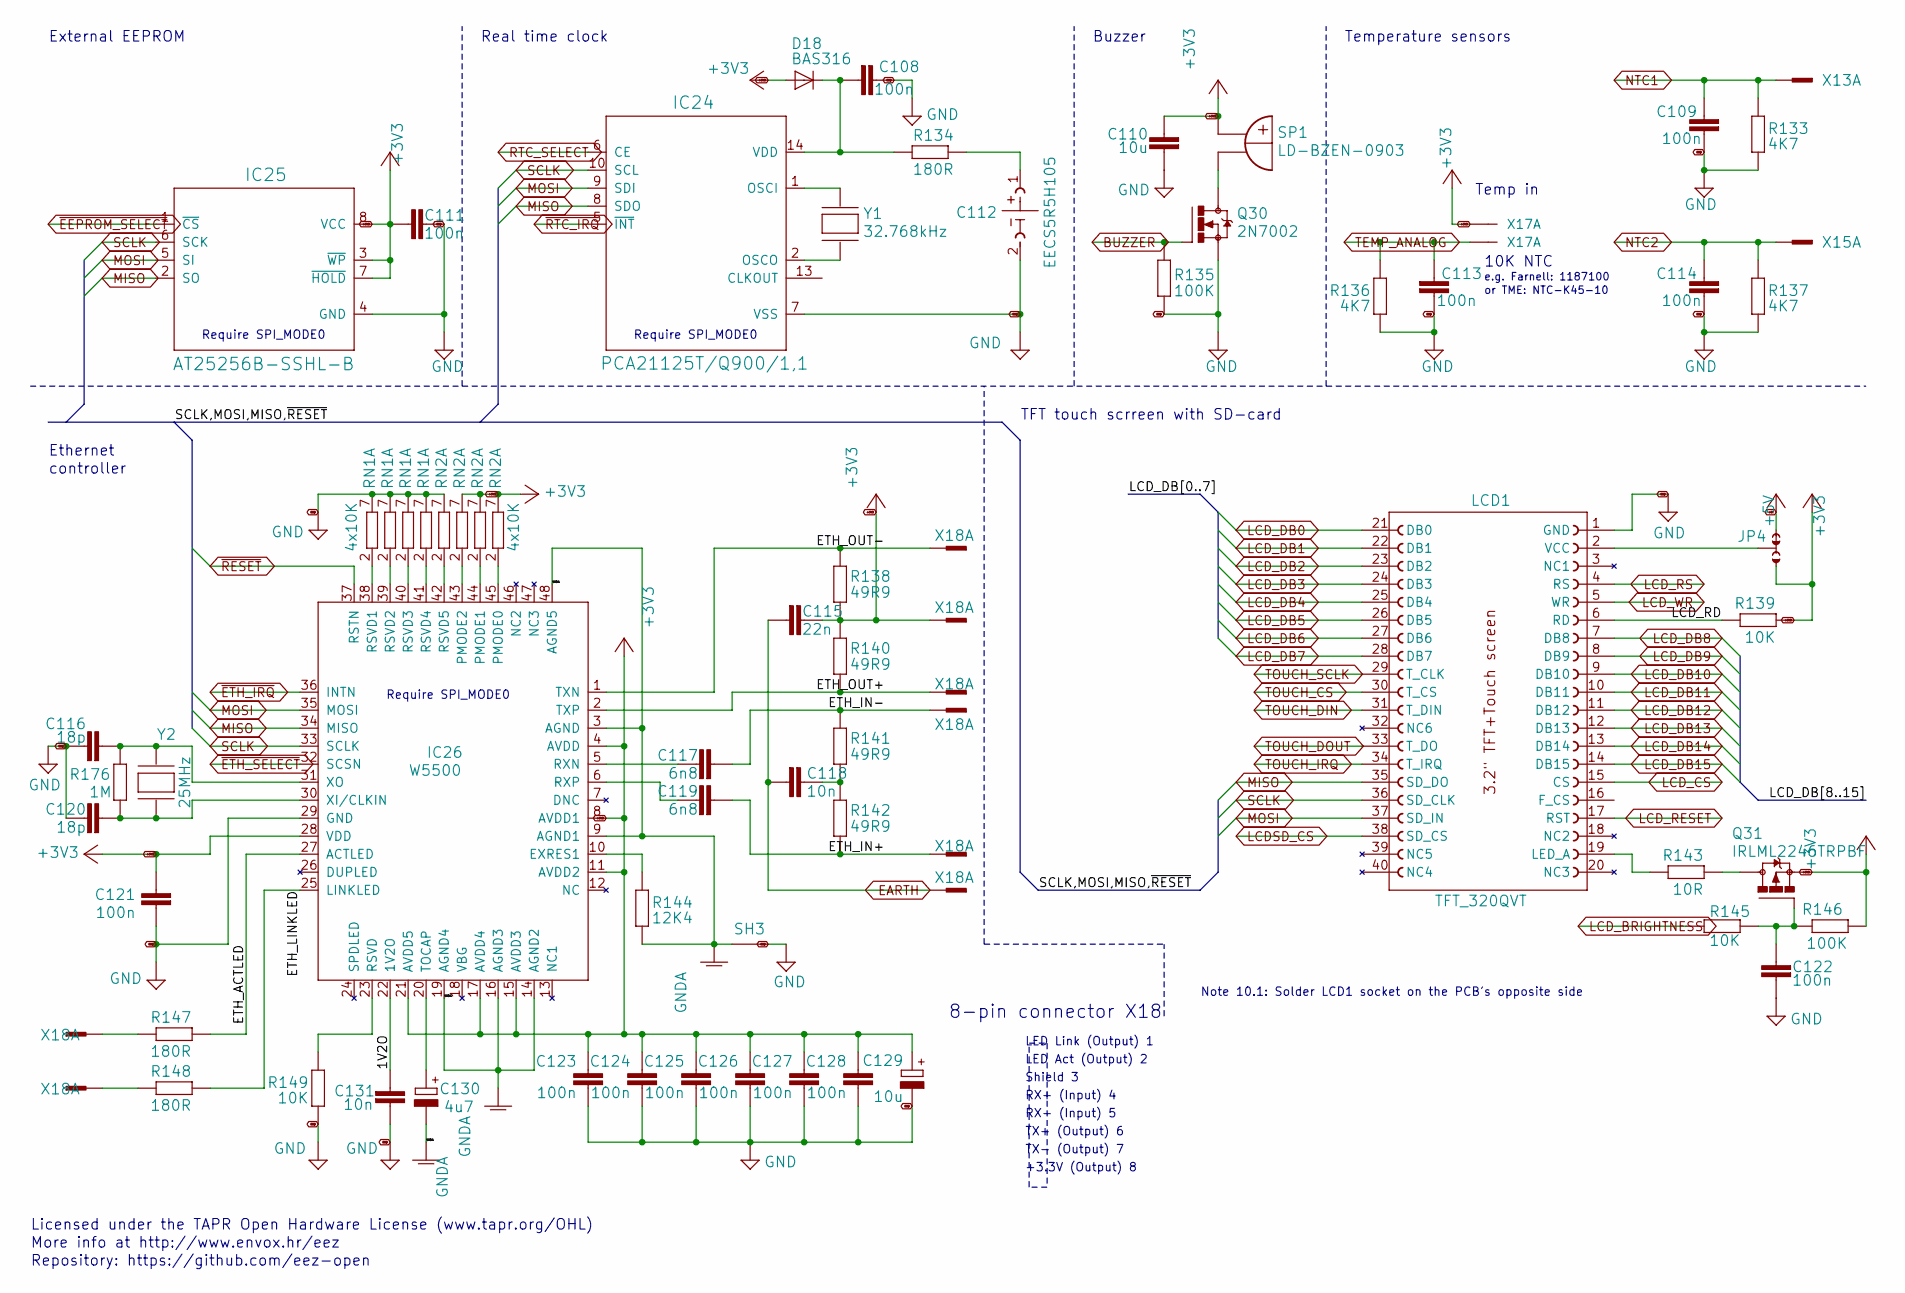
[picture p12: schematic SPI_peripherals,_TFT_display.kicad_sch]

Parts:
C108, C109, C111, C113, C114, C121, C122, C123, C124, C125, C126, C127, C128: 100n; C0603
C110: 10u; C1210
C112: EECS5R5H105; SG-R20MM
C115: 22n; C0805
C116, C120: 18p; C0805
C117, C119: 6n8; C0603
C118, C131: 10n; C0805
C129: 10u; EC1206
C130: 4u7; EC1206
D18: BAS316; SOD323-W
IC24: PCA21125T/Q900/1,1; SOP65P640X120-14N
IC25: AT25256B-SSHL-B; SOIC127P600X175-8N
IC26: W5500; TQFP48-7X7
JP4: JP3-CUT
LCD1: TFT_320QVT; LCD_TFT_9341_MIRROR
Q30: 2N7002; SOT103P240X110-3N
Q31: IRLML2246TRPBF; SOT95P237X112-3N
R133, R136, R137: 4K7; R0805
R134, R147, R148: 180R; R0805
R135, R146: 100K; R0805
R138, R140, R141, R142: 49R9; R0805
R139, R145, R149: 10K; R0805
R143: 10R; R1206
R144: 12K4; R0805
R176: 1M; R0805
RN1, RN2: 4x10K; CAY16
SH3: SHORTNOHOLE; SHORT_NOHOLE
SP1: LD-BZEN-0903
X13, X15: TSW-113-07-F-D
X17: 22-23-2021
X18: MC34753; HEADER_8-PIN
Y1: 32.768kHz; R26_XTAL
Y2: 25MHz; HC-49_4H

Connections:
1V2O: C131.2, IC26.22 (1V2O)
+3V3: C110.2, C111.1, C115.1, C121.2, C123.1, C124.1, C125.1, C126.1, C127.1, C128.1, C129.+, D18.A, IC25.3 (~WP), IC25.7 (~HOLD), IC25.8 (VCC), IC26.4 (AVDD), IC26.8 (AVDD1), IC26.11 (AVDD2), IC26.15 (AVDD3), IC26.17 (AVDD4), IC26.21 (AVDD5), IC26.28 (VDD), JP4.NO, Q31.2 (S), R138.1, R139.2, R140.2, R146.2, RN2.7 (2), SP1.+B (+), X17.1, X18.1
+5V: JP4.NC
BUZZER: Q30.1 (G), R135.2
EARTH: C115.2, C118.2, X18.1
ETH_ACTLED: IC26.27 (ACTLED), R147.1
ETH_IN+: C119.1, R142.1, X18.1
ETH_IN-: C117.1, R141.2, X18.1
ETH_LINKLED: IC26.25 (LINKLED), R148.1
ETH_OUT+: IC26.2 (TXP), R140.1, X18.1
ETH_OUT-: IC26.1 (TXN), R138.2, X18.1
GND: C108.1, C109.1, C110.1, C111.2, C112.2 (-), C113.1, C114.1, C116.2, C120.2, C121.1, C122.1, C123.2, C124.2, C125.2, C126.2, C127.2, C128.2, C129.-, C131.1, IC24.7 (VSS), IC25.4 (GND), IC26.29 (GND), LCD1.1 (GND), Q30.2 (S), R133.2, R135.1, R136.2, R137.2, R149.1, RN1.7 (2), RN2.7 (2), SH3.P$1 (GND_A)
GNDA: C130.-, IC26.3 (AGND), IC26.9 (AGND1), IC26.14 (AGND2), IC26.16 (AGND3), IC26.19 (AGND4), IC26.48 (AGND5), R144.1, SH3.P$2 (GND_B)
LCDSD_CS: LCD1.38 (SD_CS)
LCD_BRIGHTNESS: R145.1
LCD_CS: LCD1.15 (CS)
LCD_DB0: LCD1.21 (DB0)
LCD_DB1: LCD1.22 (DB1)
LCD_DB2: LCD1.23 (DB2)
LCD_DB3: LCD1.24 (DB3)
LCD_DB4: LCD1.25 (DB4)
LCD_DB5: LCD1.26 (DB5)
LCD_DB6: LCD1.27 (DB6)
LCD_DB7: LCD1.28 (DB7)
LCD_DB8: LCD1.7 (DB8)
LCD_DB9: LCD1.8 (DB9)
LCD_DB10: LCD1.9 (DB10)
LCD_DB11: LCD1.10 (DB11)
LCD_DB12: LCD1.11 (DB12)
LCD_DB13: LCD1.12 (DB13)
LCD_DB14: LCD1.13 (DB14)
LCD_DB15: LCD1.14 (DB15)
LCD_RD: LCD1.6 (RD), R139.1
LCD_RESET: LCD1.17 (RST)
LCD_RS: LCD1.4 (RS)
LCD_WR: LCD1.5 (WR)
MISO: IC24.8 (SDO), IC25.2 (SO), IC26.34 (MISO), LCD1.35 (SD_DO)
MOSI: IC24.9 (SDI), IC25.5 (SI), IC26.35 (MOSI), LCD1.37 (SD_IN)
NTC1: C109.2, R133.1, X13.1
NTC2: C114.2, R137.1, X15.1
unnamed: C108.2, D18.C, IC24.14 (VDD), R134.2
unnamed: C112.1 (+), R134.1
unnamed: C116.1, IC26.31 (XO), R176.2, Y2.1
unnamed: C117.2, IC26.5 (RXN)
unnamed: C118.1, R141.1, R142.2
unnamed: C119.2, IC26.6 (RXP)
unnamed: C120.1, IC26.30 (XI/CLKIN), R176.1, Y2.2
unnamed: C122.2, Q31.1 (G), R145.2, R146.1
unnamed: C130.+, IC26.20 (TOCAP)
unnamed: IC24.1 (OSCI), Y1.2
unnamed: IC24.2 (OSCO), Y1.1
unnamed: IC26.10 (EXRES1), R144.2
unnamed: IC26.23 (RSVD), R149.2
unnamed: IC26.38 (RSVD1), RN1.2 (1)
unnamed: IC26.39 (RSVD2), RN1.2 (1)
unnamed: IC26.40 (RSVD3), RN1.2 (1)
unnamed: IC26.41 (RSVD4), RN1.2 (1)
unnamed: IC26.42 (RSVD5), RN2.2 (1)
unnamed: IC26.43 (PMODE2), RN2.2 (1)
unnamed: IC26.44 (PMODE1), RN2.2 (1)
unnamed: IC26.45 (PMODE0), RN2.2 (1)
unnamed: JP4.COM, LCD1.2 (VCC)
unnamed: LCD1.19 (LED_A), R143.2
unnamed: Q30.3 (D), SP1.-B (-)
unnamed: Q31.3 (D), R143.1
unnamed: R147.2, X18.1
unnamed: R148.2, X18.1
RTC_SELECT: IC24.6 (CE)
SCLK: IC24.10 (SCL), IC25.6 (SCK), IC26.33 (SCLK), LCD1.36 (SD_CLK)
TEMP_ANALOG: C113.2, R136.1, X17.1
TOUCH_CS: LCD1.30 (T_CS)
TOUCH_DIN: LCD1.31 (T_DIN)
TOUCH_DOUT: LCD1.33 (T_DO)
TOUCH_IRQ: LCD1.34 (T_IRQ)
TOUCH_SCLK: LCD1.29 (T_CLK)
~EEPROM_SELECT: IC25.1 (~CS)
~ETH_IRQ: IC26.36 (INTN)
~ETH_SELECT: IC26.32 (SCSN)
~RESET: IC26.37 (RSTN)
~RTC_IRQ: IC24.5 (~INT)

Notes on the sheet:
Licensed under the TAPR Open Hardware License (www.tapr.org/OHL)
More info at http://www.envox.hr/eez
Repository: https://github.com/eez-open
External EEPROM
Ethernet
controller
Require SPI_MODE0
Real time clock
8-pin connector X18
TFT touch scrreen with SD-card
LED Link (Output) 1
LED Act (Output) 2
Shield 3
RX+ (Input) 4
RX- (Input) 5
TX+ (Output) 6
TX- (Output) 7
+3.3V (Output) 8
Buzzer
Note 10.1: Solder LCD1 socket on the PCB's opposite side
Temperature sensors
Temp in
10K NTC
e.g. Farnell: 1187100
or TME: NTC-K45-10
